Club-INTech/TechTheLunatic-LowLevel/datasheet/STM32F4/Pinout_STM32_F4DISCOVERY.xls

Sheet: Module Pins
STM32F4-Discovery Module - Pinouts & Alternate Functions (Sorted by Module Pin Order)
Kornak-(STM32-Discovery-F4)-0001 Rev n.nn Module Pinouts & Functions.xls
 |  |  |  |  |  |  | GND | P1.1 | P1.2 | GND | GND | P2.1 | P2.2 | GND
Version | Date | Who | Description |  |  |  | VDD | P1.3 | P1.4 | VDD | 5V | P2.3 | P2.4 | 5V
1.00 | 2011-12-19 | SK | Original Release. |  |  |  | GND | P1.5 | P1.6 | NRST | 3V | P2.5 | P2.6 | 3V
1.01 | 2014-09-17 | SK | Web page links updated for BusBoard.com |  |  |  | PC1 | P1.7 | P1.8 | PC0 | PH0 | P2.7 | P2.8 | PH1
 |  |  |  |  |  |  | PC3 | P1.9 | P1.10 | PC2 | PC14 | P2.9 | P2.10 | PC15
 |  |  |  |  |  |  | PA1 | P1.11 | P1.12 | PA0 | PE6 | P2.11 | P2.12 | PC13
 |  |  |  |  |  |  | PA3 | P1.13 | P1.14 | PA2 | PE4 | P2.13 | P2.14 | PE5
 |  |  |  |  |  |  | PA5 | P1.15 | P1.16 | PA4 | PE2 | P2.15 | P2.16 | PE3
 |  |  |  |  |  |  | PA7 | P1.17 | P1.18 | PA6 | PE0 | P2.17 | P2.18 | PE1
 |  |  |  |  |  |  | PC5 | P1.19 | P1.20 | PC4 | PB8 | P2.19 | P2.20 | PB9
 |  |  |  |  |  |  | PB1 | P1.21 | P1.22 | PB0 | BOOT0 | P2.21 | P2.22 | VDD | VDD connected to 3V on module.
 |  |  |  |  |  |  | GND | P1.23 | P1.24 | PB2 | PB6 | P2.23 | P2.24 | PB7
Update the version history above when making changes. |  |  |  |  |  |  | PE7 | P1.25 | P1.26 | PE8 | PB4 | P2.25 | P2.26 | PB5
 |  |  |  |  |  |  | PE9 | P1.27 | P1.28 | PE10 | PD7 | P2.27 | P2.28 | PB3
 |  |  |  |  |  |  | PE11 | P1.29 | P1.30 | PE12 | PD5 | P2.29 | P2.30 | PD6
Pins are sorted in Discovery board pin order on this page. |  |  |  |  |  |  | PE13 | P1.31 | P1.32 | PE14 | PD3 | P2.31 | P2.32 | PD4
Pins are sorted by function and MCU pin order |  |  |  |  |  |  | PE15 | P1.33 | P1.34 | PB10 | PD1 | P2.33 | P2.34 | PD2
on the other spreadsheet tabs. |  |  |  |  |  |  | PB11 | P1.35 | P1.36 | PB12 | PC12 | P2.35 | P2.36 | PD0
 |  |  |  |  |  |  | PB13 | P1.37 | P1.38 | PB14 | PC10 | P2.37 | P2.38 | PC11
 |  |  |  |  |  |  | PB15 | P1.39 | P1.40 | PD8 | PA14 | P2.39 | P2.40 | PA15
 |  |  |  |  |  |  | PD9 | P1.41 | P1.42 | PD10 | PA10 | P2.41 | P2.42 | PA13
 |  |  | Place the pin function |  |  |  | PD11 | P1.43 | P1.44 | PD12 | PA8 | P2.43 | P2.44 | PA9
 |  |  | and name for your |  |  |  | PD13 | P1.45 | P1.46 | PD14 | PC8 | P2.45 | P2.46 | PC9
 |  |  | project here. |  |  |  | PD15 | P1.47 | P1.48 | NC | PC6 | P2.47 | P2.48 | PC7
 |  |  | V V V V V V V V |  |  |  | GND | P1.49 | P1.50 | GND | GND | P2.49 | P2.50 | GND
 |  |  |  |  |  |  |  | Note: Color codes are different below
STM32F4 Pin | Discovery F4 Pin | LQFP100 | Project Pin Name and Function | Notes | Discovery F4 Usage | I/O Level | Function (1) after reset | Alternate functions (2)
PA11 | CN5 (USB) | 70 | PA11-OTG_FS_DM |  | USB-FS | FT | PA11 | USART1_CTS | CAN1_RX | TIM1_CH4 | OTG_FS_DM
PA12 | CN5 (USB) | 71 | PA12-OTG_FS_DP |  | USB-FS | FT | PA12 | USART1_RTS | CAN1_TX | TIM1_ETR | OTG_FS_DP
GND | P1.1 |  | GND1
GND | P1.2 |  | GND2
VDD | P1.3 |  | VDD1
VDD | P1.4 |  | VDD2
GND | P1.5 |  | GND3
NRST | P1.6 | 14 | NRST |  | Reset Button |  | NRST
PC1 | P1.7 | 16 | PC1-ADC123_IN11 | 5 |  | FT | PC1 | ETH_MDC | ADC123_IN11
PC0 | P1.8 | 15 | PC0-OTG_ FS_ Power | 5 | USB-FS | FT | PC0 | OTG_HS_ULPI_STP | ADC123_IN10
PC3 | P1.9 | 18 | PC3-MIC_PDM | 5 | MIC PDM | FT | PC3 | SPI2_MOSI | I2S2_SD | OTG_HS_ULPI_NXT | ETH_MII_TX_CLK | ADC123_IN13
PC2 | P1.10 | 17 | PC2-ADC123_IN12 | 5 |  | FT | PC2 | SPI2_MISO | OTG_HS_ULPI_DIR | TH_MII_TXD2 | I2S2ext_SD | ADC123_IN12
PA1 | P1.11 | 24 | PA1-USART4_RX | 5 |  | FT | PA1 | USART2_RTS | USART4_RX | ETH_RMII_REF_CLK | ETH_MII_RX_CLK | TIM5_CH2 | TIMM2_CH2 | ADC123_IN1
PA0-WKUP | P1.12 | 23 | PA0-WKUP-USART4_TX | 6,5 | User Button | FT | PA0-WKUP | USART2_CTS | USART4_TX | ETH_MII_CRS | TIM2_CH1_ETR | TIM5_CH1 | TIM8_ETR | ADC123_IN0 | WKUP
PA3 | P1.13 | 26 | PA3-USART2_RX | 5 |  | FT | PA3 | USART2_RX | TIM5_CH4 | TIM9_CH2 | TIM2_CH4 | OTG_HS_ULPI_D0 | ETH_MII_COL | ADC123_IN3
PA2 | P1.14 | 25 | PA2-USART2_TX | 5 |  | FT | PA2 | USART2_TX | TIM5_CH3 | TIM9_CH1 | TIM2_CH3 | ETH_MDIO | ADC123_IN2
PA5 | P1.15 | 30 | PA5-SPI1_SCK | 5 | MEMS SCLK | FT | PA5 | SPI1_SCK | OTG_HS_ULPI_CK | TIM2_CH1_ETR | TIM8_CHIN | ADC12_IN5 | DAC2_OUT
PA4 | P1.16 | 29 | PA4-I2S3_WS | 5 | DAC | FT | PA4 | SPI1_NSS | SPI3_NSS | USART2_CK | DCMI_HSYNC | OTG_HS_SOF | I2S3_WS | ADC12_IN4 | DAC1_OUT
PA7 | P1.17 | 32 | PA7-SPI1_MOSI | 5 | MEMS MOSI | FT | PA7 | SPI1_MOSI | TIM8_CH1N | TIM14_CH1 | TIM3_CH2 | ETH_MII_RX_DV | TIM1_CH1 | NRMII_CRS_DV | ADC12_IN7
PA6 | P1.18 | 31 | PA6-SPI1_MISO | 5 | MEMS MISO | FT | PA6 | SPI1_MISO | TIM8_BKIN | TIM13_CH1 | DCMI_PIXCLK | TIM3_CH1 | TIM1_BKIN | ADC12_IN6
PC5 | P1.19 | 34 | PC5-ADC12_IN15 | 5 |  | FT | PC5 | ETH_RMII_RX_D1 | ETH_MII_RX_D1 | ADC12_IN15
PC4 | P1.20 | 33 | PC4-ADC12_IN14 | 5 |  | FT | PC4 | ETH_RMII_RX_D0 | ETH_MII_RX_D0 | ADC12_IN14
PB1 | P1.21 | 36 | PB1-ADC12_IN9 | 5 |  | FT | PB1 | TIM3_CH4 | TIM8_CH3N | OTG_HS_ULPI_D2 | ETH_MII_RXD3 | OTG_HS_INTN | TIM1_CH3N | ADC12_IN9
PB0 | P1.22 | 35 | PB0-ADC12_IN8 | 5 |  | FT | PB0 | TIM3_CH3 | TIM8_CH2N | OTG_HS_ULPI_D1 | ETH_MII_RXD2 | TIM1_CH2N | ADC12_IN8
GND | P1.23 |  | GND4
PB2 | P1.24 | 37 | PB2-BOOT1 |  |  | FT | PB2-BOOT1
PE7 | P1.25 | 38 | PE7 |  |  | FT | PE7 | FSMC_D4 | TIM1_ETR
PE8 | P1.26 | 39 | PE8 |  |  | FT | PE8 | FSMC_D5 | TIM1_CH1N
PE9 | P1.27 | 40 | PE9 |  |  | FT | PE9 | FSMC_D6 | TIM1_CH1
PE10 | P1.28 | 41 | PE10 |  |  | FT | PE10 | FSMC_D7 | TIM1_CH2N
PE11 | P1.29 | 42 | PE11 |  |  | FT | PE11 | FSMC_D8 | TIM1_CH2
PE12 | P1.30 | 43 | PE12 |  |  | FT | PE12 | FSMC_D9 | TIM1_CH3N
PE13 | P1.31 | 44 | PE13 |  |  | FT | PE13 | FSMC_D10 | TIM1_CH3
PE14 | P1.32 | 45 | PE14 |  |  | FT | PE14 | FSMC_D11 | TIM1_CH4
PE15 | P1.33 | 46 | PE15 |  |  | FT | PE15 | FSMC_D12 | TIM1_BKIN
PB10 | P1.34 | 47 | PB10-I2C2_SCL |  | Also MIC CLK | FT | PB10 | SPI2_SCK | I2S2_CK | I2C2_SCL | USART3_TX | OTG_HS_ULPI_D3 | ETH_MII_RX_ER | OTG_HS_SCL | TIM2_CH3
PB11 | P1.35 | 48 | PB11-I2C2_SDA |  |  | FT | PB11 | I2C2_SDA | USART3_RX | OTG_HS_ULPI_D4 | ETH_RMII_TX_EN | ETH_MII_TX_EN | OTG_HS_SDA | TIM2_CH4
PB12 | P1.36 | 51 | PB12-SPI2_NSS |  |  | FT | PB12 | SPI2_NSS | I2S2_WS | I2C2_SMBA | USART3_CK | TIM1_BKIN | CAN2_RX | OTG_HS_ULPI_D5 | ETH_RMII_TXD0 | ETH_MII_TXD0 | OTG_HS_ID
PB13 | P1.37 | 52 | PB13-SPI2_SCK |  |  | FT | PB13 | SPI2_SCK | I2S2_CK | USART3_CTS | TIM1_CH1N | CAN2_TX | OTG_HS_ULPI_D6 | ETH_RMII_TXD1 | ETH_MII_TXD1 | OTG_HS_VBUS
PB14 | P1.38 | 53 | PB14-SPI2_MISO |  |  | FT | PB14 | SPI2_MISO | TIM1_CH2N | TIM12_CH1 | OTG_HS_DM | USART3_RTS | TIM8_CH2N | I2S2ext_SD
PB15 | P1.39 | 54 | PB15-SPI2_MOSI |  |  | FT | PB15 | SPI2_MOSI | I2S2_SD | TIM1_CH3N | TIM8_CH3N | TIM12_CH2 | OTG_HS_DP
PD8 | P1.40 | 55 | PD8-USART3_TX |  |  | FT | PD8 | FSMC_D13 | USART3_TX
PD9 | P1.41 | 56 | PD9-USART3_RX |  |  | FT | PD9 | FSMC_D14 | USART3_RX
PD10 | P1.42 | 57 | PD10 |  |  | FT | PD10 | FSMC_D15 | USART3_CK
PD11 | P1.43 | 58 | PD11-USART3_CTS |  |  | FT | PD11 | FSMC_A16 | USART3_CTS
PD12 | P1.44 | 59 | PD12-USART3_RTS |  | LED Green | FT | PD12 | FSMC_A17 | TIM4_CH1 | USART3_RTS
PD13 | P1.45 | 60 | PD13 |  | LED Orange | FT | PD13 | FSMC_A18 | TIM4_CH2
PD14 | P1.46 | 61 | PD14 |  | LED Red | FT | PD14 | FSMC_D0 | TIM4_CH3
PD15 | P1.47 | 62 | PD15 |  | LED Blue | FT | PD15 | FSMC_D1 | TIM4_CH4
NC | P1.48 |  | NC
GND | P1.49 |  | GND5
GND | P1.50 |  | GND6
GND | P2.1 (51) |  | GND7
GND | P2.2 (52) |  | GND8
5V | P2.3 (53) |  | 5V-1
5V | P2.4 (54) |  | 5V-2
3V | P2.5 (55) |  | 3V-1
3V | P2.6 (56) |  | 3V-2
PH0 | P2.7 (57) | 12 | PH0-OSC_IN | 5 |  | FT | PH0 | OSC_IN
PH1 | P2.8 (58) | 13 | PH1-OSC_OUT | 5 |  | FT | PH1 | OSC_OUT
PC14 | P2.9 (59) | 8 | PC14-OSC32_IN | 3,5 |  | FT | PC14(4) | OSC32_IN
PC15 | P2.10 (60) | 9 | PC15-OSC32_OUT | 3,5 |  | FT | PC15(4) | OSC32_OUT
PE6 | P2.11 (61) | 5 | PE6 |  |  | FT | PE6 | TRACED3 | FSMC_A22 | TIM9_CH2 | DCMI_D7
PC13 | P2.12 (62) | 7 | PC13 | 3,4 |  | FT | PC13(4) | RTC_AF1
PE4 | P2.13 (63) | 3 | PE4 |  |  | FT | PE4 | TRACED1 | FSMC_A20 | DCMI_D4
PE5 | P2.14 (64) | 4 | PE5 |  |  | FT | PE5 | TRACED2 | FSMC_A21 | TIM9_CH1 | DCMI_D6
PE2 | P2.15 (65) | 1 | PE2 |  |  | FT | PE2 | TRACECLK | FSMC_A23 | ETH_MII_TXD3
PE3 | P2.16 (66) | 2 | PE3 |  | MEMS CS_I2C_SPI | FT | PE3 | TRACED0 | FSMC_A19
PE0 | P2.17 (67) | 97 | PE0 |  | MEMS INT1 | FT | PE0 | TIM4_ETR | FSMC_NBL0 | DCMI_D2
PE1 | P2.18 (68) | 98 | PE1 |  | MEMS INT2 | FT | PE1 | FSMC_NBL1 | DCMI_D3
PB8 | P2.19 (69) | 95 | PB8 |  |  | FT | PB8 | TIM4_CH3 | SDIO_D4 | TIM10_CH1 | DCMI_D6 | OTG_FS_SCL | ETH_MII_TXD3 | I2C1_SCL | CAN1_RX
PB9 | P2.20 (70) | 96 | PB9-I2C1_SDA |  | DAC I2C | FT | PB9 | SPI2_NSS | I2S2_WS | TIM4_CH4 | TIM11_CH1 | OTG_FS_SDA | SDIO_D5 | DCMI_D7 | I2C1_SDA | CAN1_TX
BOOT0 | P2.21 (71) | 94 | BOOT0 |  |  |  | BOOT0 | VPP
VDD | P2.22 (72) |  | VDD3
PB6 | P2.23 (73) | 92 | PB6-I2C1_SCL |  | DAC I2C | FT | PB6 | I2C1_SCL | TIM4_CH1 | CAN2_TX | OTG_FS_INTN | DCMI_D5 | USART1_TX
PB7 | P2.24 (74) | 93 | PB7 |  |  | FT | PB7 | I2C1_SDA | FSMC_NL | DCMI_VSYNC | USART1_RX | TIM4_CH2
PB4 | P2.25 (75) | 90 | PB4-NJTRST |  |  | FT | NJTRST | NJTRST | SPI3_MISO | TIM3_CH1 | SPI1_MISO | I2S3ext_SD
PB5 | P2.26 (76) | 91 | PB5-I2C1_SMBA |  |  | FT | PB5 | I2C1_SMBA | CAN2_RX | OTG_HS_ULPI_D7 | ETH_PPS_OUT | TIM3_CH2 | SPI1_MOSI | SPI3_MOSI | DCMI_D10 | I2S3_SD
PD7 | P2.27 (77) | 88 | PD7 |  |  | FT | PD7 | USART2_CK | FSMC_NE1 | FSMC_NCE2
PB3 | P2.28 (78) | 89 | PB3-JTDO |  |  | FT | JTDO | TRACESWO | JTDO | SPI3_SCK | I2S3_CK | SPI1_SCK | TIM2_CH2
PD5 | P2.29 (79) | 86 | PD5-OTG_ FS_ OverCurrent |  | USB-FS | FT | PD5 | FSMC_NWE | USART2_TX
PD6 | P2.30 (80) | 87 | PD6 |  |  | FT | PD6 | FSMC_NWAIT | USART2_RX
PD3 | P2.31 (81) | 84 | PD3 |  |  | FT | PD3 | FSMC_CLK | USART2_CTS
PD4 | P2.32 (82) | 85 | PD4-AUDIO_RESET_N |  | DAC-Reset-N | FT | PD4 | FSMC_NOE | USART2_RTS
PD1 | P2.33 (83) | 82 | PD1-CAN1_TX |  |  | FT | PD1 | FSMC_D3 | CAN1_TX
PD2 | P2.34 (84) | 83 | PD2 |  |  | FT | PD2 | TIM3_ETR | UART5_RX | SDIO_CMD | DCMI_D11
PC12 | P2.35 (85) | 80 | PC12-I2S3_SD |  | DAC | FT | PC12 | UART5_TX | SDIO_CK | DCMI_D9 | SPI3_MOSI | I2S3_SD | USART3_CK
PD0 | P2.36 (86) | 81 | PD0-CAN1_RX |  |  | FT | PD0 | FSMC_D2 | CAN1_RX
PC10 | P2.37 (87) | 78 | PC10-I2S3_CK |  | DAC | FT | PC10 | SPI3_SCK | I2S3_CK | UART4_TX | SDIO_D2 | USART3_TX | DCMI_D8
PC11 | P2.38 (88) | 79 | PC11 |  |  | FT | PC11 | UART4_RX | SPI3_MISO | SDIO_D3 | DCMI_D4 | USART3_RX | I2S3ext_SD
PA14 | P2.39 (89) | 76 | PA14-JTCK-SWCLK |  |  | FT | JTCK-SWCLK | JTCK-SWCLK
PA15 | P2.40 (90) | 77 | PA15-JTDI |  |  | FT | JTDI | JTDI | SPI3_NSS | I2S3_WS | TIM2_CH1_ETR | SPI1_NSS
PA10 | P2.41 (91) | 69 | PA10-OTG_FS_ID |  | USB-FS | FT | PA10 | USART1_RX | TIM1_CH3 | OTG_FS_ID | DCMI_D1
PA13 | P2.42 (92) | 72 | PA13-JTMS-SWDIO |  |  | FT | JTMS-SWDIO | JTMS-SWDIO
PA8 | P2.43 (93) | 67 | PA8-I2C3_SCL |  |  | FT | PA8 | MCO1 | USART1_CK | TIM1_CH1 | I2C3_SCL | OTG_FS_SOF
PA9 | P2.44 (94) | 68 | PA9-OTG_FS_VBUS |  | USB-FS | FT | PA9 | USART1_TX | TIM1_CH2 | I2C3_SMBA | DCMI_D0 | OTG_FS_VBUS
PC8 | P2.45 (95) | 65 | PC8 |  |  | FT | PC8 | TIM8_CH3 | SDIO_D0 | TIM3_CH3 | USART6_CK | DCMI_D2
PC9 | P2.46 (96) | 66 | PC9-I2C3_SDA |  |  | FT | PC9 | I2S_CKIN | MCO2 | TIM8_CH4 | SDIO_D1 | DCMI_D3 | TIM3_CH4 | I2C3_SDA
PC6 | P2.47 (97) | 63 | PC6 |  |  | FT | PC6 | I2S2_MCK | TIM8_CH1 | SDIO_D6 | USART6_TX | DCMI_D0 | TIM3_CH1
PC7 | P2.48 (98) | 64 | PC7-I2S3_MCK |  | DAC | FT | PC7 | I2S3_MCK | TIM8_CH2 | SDIO_D7 | USART6_RX | DCMI_D1 | TIM3_CH2
GND | P2.49 (99) |  | GND9
GND | P2.50 (100) |  | GND10
 |  |  |  | See pin notes on the "MCU pins" tab/sheet.
The pin information is Copyright 2011 ST Microelectronics.
This spreadsheet, additional information, and the table organization is Copyright 2011 by Kornak Technologies Inc.
This spreadsheet may be freely distributed and modified for personal or commercial use with the Copyright attributions intact.
Kornak Technologies provides embedded product development and manufacturing services
including STM32 hardware and firmware development. |  |  |  |  |  |  |  |  |  |  | www.Kornak.ca
This spreadsheet and updated versions can be downloaded from: |  |  |  |  |  | http://busboard.us/products/PCB-STM32-F4B1/ (http://www.kornak.ca/parts/stm32-discovery-f4/)
The BusBoard STM32-F4B1 breakout board is available for the STMicro Discovery-F4 module.
Datasheets, photos, BOMs, and schematics are available at: |  |  |  |  |  | http://busboard.com/PCB-STM32-F4B1/
The BusBoard-3U (BB3U) prototyping board can be used to create a baseboard for the STM32F4 Discovery module.
The zig-zag pattern is helpful for the STM32F4-Discovery module because it keeps both sides of the DIL header on separate tracks. |  |  |  |  |  |  |  |  |  |  | www.BusBoard.com
It can be used to connect two DIL headers pin-to-pin without cutting any tracks. |  |  |  |  |  |  | http://busboard.com/KIT-BB2-F3-F4
 |  |  |  |  |  |  | http://busboard.com/KIT-BB3-F3-F4
BPS also sells high-quality solderless breadboards and solderable PC prototyping boards
which can help with Discovery-F4 interfacing.
BB400 breadboards make great bases for STM32 Discovery-L and Discovery-VL modules with SIL headers.
BPS products are available at:
www.Mouser.com |  |  | BPS Products at Mouser (http://www.mouser.com/bps)
www.Amazon.com |  |  | BPS Products at Amazon.com (http://www.amazon.com/shops/A2RKGEIGG4B1JT/ref=olp_merch_name_1)
www.Amazon.co.uk |  |  | BPS Products at Amazon.co.uk (http://www.amazon.co.uk/s?search-type=ss&index=electronics-uk&field-keywords=BusBoard%20Prototype%20Systems)

Sheet: By Function
STM32F4-Discovery Module - Pinouts & Alternate Functions (Sorted by typical Pin Function)
Kornak-(STM32-Discovery-F4)-0001 Rev n.nn Module Pinouts & Functions.xls
 |  |  | The formulas |  | This spreadsheet is intended to help you plan you project pinout assignments.
 |  |  | combine the pin name
 |  |  | with the function. |  | Rearrange the rows according to the pin functions you choose to group pins with common functions.
 |  |  | V V V V V V V V
STM32F4 Pin | Discovery F4 Pin | LQFP100 | Project Pin Name and Function | Notes | Discovery F4 Usage | I/O Level | Function (1) after reset | Alternate functions (2)
PA11 | CN5 (USB) | 70 | PA11-OTG_FS_DM |  | USB-FS | FT | PA11 | USART1_CTS | CAN1_RX | TIM1_CH4 | OTG_FS_DM
PA12 | CN5 (USB) | 71 | PA12-OTG_FS_DP |  | USB-FS | FT | PA12 | USART1_RTS | CAN1_TX | TIM1_ETR | OTG_FS_DP
PA9 | P2.44 | 68 | PA9-OTG_FS_VBUS |  | USB-FS | FT | PA9 | USART1_TX | TIM1_CH2 | I2C3_SMBA | DCMI_D0 | OTG_FS_VBUS
PA10 | P2.41 | 69 | PA10-OTG_FS_ID |  | USB-FS | FT | PA10 | USART1_RX | TIM1_CH3 | OTG_FS_ID | DCMI_D1
PC0 | P1.8 | 15 | PC0-OTG_ FS_ Power | 5 | USB-FS | FT | PC0 | OTG_HS_ULPI_STP | ADC123_IN10
PD5 | P2.29 | 86 | PD5-OTG_ FS_ OverCurrent |  | USB-FS | FT | PD5 | FSMC_NWE | USART2_TX
PA2 | P1.14 | 25 | PA2-USART2_TX | 5 |  | FT | PA2 | USART2_TX | TIM5_CH3 | TIM9_CH1 | TIM2_CH3 | ETH_MDIO | ADC123_IN2
PA3 | P1.13 | 26 | PA3-USART2_RX | 5 |  | FT | PA3 | USART2_RX | TIM5_CH4 | TIM9_CH2 | TIM2_CH4 | OTG_HS_ULPI_D0 | ETH_MII_COL | ADC123_IN3
PD8 | P1.40 | 55 | PD8-USART3_TX |  |  | FT | PD8 | FSMC_D13 | USART3_TX
PD9 | P1.41 | 56 | PD9-USART3_RX |  |  | FT | PD9 | FSMC_D14 | USART3_RX
PD11 | P1.43 | 58 | PD11-USART3_CTS |  |  | FT | PD11 | FSMC_A16 | USART3_CTS
PD12 | P1.44 | 59 | PD12-USART3_RTS |  | LED Green | FT | PD12 | FSMC_A17 | TIM4_CH1 | USART3_RTS
PA0-WKUP | P1.12 | 23 | PA0-WKUP-USART4_TX | 6,5 | User Button | FT | PA0-WKUP | USART2_CTS | USART4_TX | ETH_MII_CRS | TIM2_CH1_ETR | TIM5_CH1 | TIM8_ETR | ADC123_IN0 | WKUP
PA1 | P1.11 | 24 | PA1-USART4_RX | 5 |  | FT | PA1 | USART2_RTS | USART4_RX | ETH_RMII_REF_CLK | ETH_MII_RX_CLK | TIM5_CH2 | TIMM2_CH2 | ADC123_IN1
PC7 | P2.48 | 64 | PC7-I2S3_MCK |  | DAC | FT | PC7 | I2S3_MCK | TIM8_CH2 | SDIO_D7 | USART6_RX | DCMI_D1 | TIM3_CH2
PC10 | P2.37 | 78 | PC10-I2S3_CK |  | DAC | FT | PC10 | SPI3_SCK | I2S3_CK | UART4_TX | SDIO_D2 | USART3_TX | DCMI_D8
PC12 | P2.35 | 80 | PC12-I2S3_SD |  | DAC | FT | PC12 | UART5_TX | SDIO_CK | DCMI_D9 | SPI3_MOSI | I2S3_SD | USART3_CK
PA4 | P1.16 | 29 | PA4-I2S3_WS | 5 | DAC | FT | PA4 | SPI1_NSS | SPI3_NSS | USART2_CK | DCMI_HSYNC | OTG_HS_SOF | I2S3_WS | ADC12_IN4 | DAC1_OUT
PD4 | P2.32 | 85 | PD4-AUDIO_RESET_N |  | DAC-Reset-N | FT | PD4 | FSMC_NOE | USART2_RTS
PD0 | P2.36 | 81 | PD0-CAN1_RX |  |  | FT | PD0 | FSMC_D2 | CAN1_RX
PD1 | P2.33 | 82 | PD1-CAN1_TX |  |  | FT | PD1 | FSMC_D3 | CAN1_TX
PB0 | P1.22 | 35 | PB0-ADC12_IN8 | 5 |  | FT | PB0 | TIM3_CH3 | TIM8_CH2N | OTG_HS_ULPI_D1 | ETH_MII_RXD2 | TIM1_CH2N | ADC12_IN8
PB1 | P1.21 | 36 | PB1-ADC12_IN9 | 5 |  | FT | PB1 | TIM3_CH4 | TIM8_CH3N | OTG_HS_ULPI_D2 | ETH_MII_RXD3 | OTG_HS_INTN | TIM1_CH3N | ADC12_IN9
PC1 | P1.7 | 16 | PC1-ADC123_IN11 | 5 |  | FT | PC1 | ETH_MDC | ADC123_IN11
PC2 | P1.10 | 17 | PC2-ADC123_IN12 | 5 |  | FT | PC2 | SPI2_MISO | OTG_HS_ULPI_DIR | TH_MII_TXD2 | I2S2ext_SD | ADC123_IN12
PC4 | P1.20 | 33 | PC4-ADC12_IN14 | 5 |  | FT | PC4 | ETH_RMII_RX_D0 | ETH_MII_RX_D0 | ADC12_IN14
PC5 | P1.19 | 34 | PC5-ADC12_IN15 | 5 |  | FT | PC5 | ETH_RMII_RX_D1 | ETH_MII_RX_D1 | ADC12_IN15
PA5 | P1.15 | 30 | PA5-SPI1_SCK | 5 | MEMS SCLK | FT | PA5 | SPI1_SCK | OTG_HS_ULPI_CK | TIM2_CH1_ETR | TIM8_CHIN | ADC12_IN5 | DAC2_OUT
PA6 | P1.18 | 31 | PA6-SPI1_MISO | 5 | MEMS MISO | FT | PA6 | SPI1_MISO | TIM8_BKIN | TIM13_CH1 | DCMI_PIXCLK | TIM3_CH1 | TIM1_BKIN | ADC12_IN6
PA7 | P1.17 | 32 | PA7-SPI1_MOSI | 5 | MEMS MOSI | FT | PA7 | SPI1_MOSI | TIM8_CH1N | TIM14_CH1 | TIM3_CH2 | ETH_MII_RX_DV | TIM1_CH1 | NRMII_CRS_DV | ADC12_IN7
PB13 | P1.37 | 52 | PB13-SPI2_SCK |  |  | FT | PB13 | SPI2_SCK | I2S2_CK | USART3_CTS | TIM1_CH1N | CAN2_TX | OTG_HS_ULPI_D6 | ETH_RMII_TXD1 | ETH_MII_TXD1 | OTG_HS_VBUS
PB14 | P1.38 | 53 | PB14-SPI2_MISO |  |  | FT | PB14 | SPI2_MISO | TIM1_CH2N | TIM12_CH1 | OTG_HS_DM | USART3_RTS | TIM8_CH2N | I2S2ext_SD
PB15 | P1.39 | 54 | PB15-SPI2_MOSI |  |  | FT | PB15 | SPI2_MOSI | I2S2_SD | TIM1_CH3N | TIM8_CH3N | TIM12_CH2 | OTG_HS_DP
PB12 | P1.36 | 51 | PB12-SPI2_NSS |  |  | FT | PB12 | SPI2_NSS | I2S2_WS | I2C2_SMBA | USART3_CK | TIM1_BKIN | CAN2_RX | OTG_HS_ULPI_D5 | ETH_RMII_TXD0 | ETH_MII_TXD0 | OTG_HS_ID
PA13 | P2.42 | 72 | PA13-JTMS-SWDIO |  |  | FT | JTMS-SWDIO | JTMS-SWDIO
PA14 | P2.39 | 76 | PA14-JTCK-SWCLK |  |  | FT | JTCK-SWCLK | JTCK-SWCLK
PA15 | P2.40 | 77 | PA15-JTDI |  |  | FT | JTDI | JTDI | SPI3_NSS | I2S3_WS | TIM2_CH1_ETR | SPI1_NSS
PB3 | P2.28 | 89 | PB3-JTDO |  |  | FT | JTDO | TRACESWO | JTDO | SPI3_SCK | I2S3_CK | SPI1_SCK | TIM2_CH2
PB4 | P2.25 | 90 | PB4-NJTRST |  |  | FT | NJTRST | NJTRST | SPI3_MISO | TIM3_CH1 | SPI1_MISO | I2S3ext_SD
PB6 | P2.23 | 92 | PB6-I2C1_SCL |  | DAC I2C | FT | PB6 | I2C1_SCL | TIM4_CH1 | CAN2_TX | OTG_FS_INTN | DCMI_D5 | USART1_TX
PB9 | P2.20 | 96 | PB9-I2C1_SDA |  | DAC I2C | FT | PB9 | SPI2_NSS | I2S2_WS | TIM4_CH4 | TIM11_CH1 | OTG_FS_SDA | SDIO_D5 | DCMI_D7 | I2C1_SDA | CAN1_TX
PB10 | P1.34 | 47 | PB10-I2C2_SCL |  | Also MIC CLK | FT | PB10 | SPI2_SCK | I2S2_CK | I2C2_SCL | USART3_TX | OTG_HS_ULPI_D3 | ETH_MII_RX_ER | OTG_HS_SCL | TIM2_CH3
PB11 | P1.35 | 48 | PB11-I2C2_SDA |  |  | FT | PB11 | I2C2_SDA | USART3_RX | OTG_HS_ULPI_D4 | ETH_RMII_TX_EN | ETH_MII_TX_EN | OTG_HS_SDA | TIM2_CH4
PB5 | P2.26 | 91 | PB5-I2C1_SMBA |  |  | FT | PB5 | I2C1_SMBA | CAN2_RX | OTG_HS_ULPI_D7 | ETH_PPS_OUT | TIM3_CH2 | SPI1_MOSI | SPI3_MOSI | DCMI_D10 | I2S3_SD
PA8 | P2.43 | 67 | PA8-I2C3_SCL |  |  | FT | PA8 | MCO1 | USART1_CK | TIM1_CH1 | I2C3_SCL | OTG_FS_SOF
PC9 | P2.46 | 66 | PC9-I2C3_SDA |  |  | FT | PC9 | I2S_CKIN | MCO2 | TIM8_CH4 | SDIO_D1 | DCMI_D3 | TIM3_CH4 | I2C3_SDA
PD13 | P1.45 | 60 | PD13 |  | LED Orange | FT | PD13 | FSMC_A18 | TIM4_CH2
PD14 | P1.46 | 61 | PD14 |  | LED Red | FT | PD14 | FSMC_D0 | TIM4_CH3
PD15 | P1.47 | 62 | PD15 |  | LED Blue | FT | PD15 | FSMC_D1 | TIM4_CH4
PC3 | P1.9 | 18 | PC3-MIC_PDM | 5 | MIC PDM | FT | PC3 | SPI2_MOSI | I2S2_SD | OTG_HS_ULPI_NXT | ETH_MII_TX_CLK | ADC123_IN13
PB7 | P2.24 | 93 | PB7 |  |  | FT | PB7 | I2C1_SDA | FSMC_NL | DCMI_VSYNC | USART1_RX | TIM4_CH2
PB8 | P2.19 | 95 | PB8 |  |  | FT | PB8 | TIM4_CH3 | SDIO_D4 | TIM10_CH1 | DCMI_D6 | OTG_FS_SCL | ETH_MII_TXD3 | I2C1_SCL | CAN1_RX
PC11 | P2.38 | 79 | PC11 |  |  | FT | PC11 | UART4_RX | SPI3_MISO | SDIO_D3 | DCMI_D4 | USART3_RX | I2S3ext_SD
PC13 | P2.12 | 7 | PC13 | 3,4 |  | FT | PC13(4) | RTC_AF1
PC6 | P2.47 | 63 | PC6 |  |  | FT | PC6 | I2S2_MCK | TIM8_CH1 | SDIO_D6 | USART6_TX | DCMI_D0 | TIM3_CH1
PC8 | P2.45 | 65 | PC8 |  |  | FT | PC8 | TIM8_CH3 | SDIO_D0 | TIM3_CH3 | USART6_CK | DCMI_D2
PD2 | P2.34 | 83 | PD2 |  |  | FT | PD2 | TIM3_ETR | UART5_RX | SDIO_CMD | DCMI_D11
PD3 | P2.31 | 84 | PD3 |  |  | FT | PD3 | FSMC_CLK | USART2_CTS
PD6 | P2.30 | 87 | PD6 |  |  | FT | PD6 | FSMC_NWAIT | USART2_RX
PD7 | P2.27 | 88 | PD7 |  |  | FT | PD7 | USART2_CK | FSMC_NE1 | FSMC_NCE2
PD10 | P1.42 | 57 | PD10 |  |  | FT | PD10 | FSMC_D15 | USART3_CK
PE0 | P2.17 | 97 | PE0 |  | MEMS INT1 | FT | PE0 | TIM4_ETR | FSMC_NBL0 | DCMI_D2
PE1 | P2.18 | 98 | PE1 |  | MEMS INT2 | FT | PE1 | FSMC_NBL1 | DCMI_D3
PE2 | P2.15 | 1 | PE2 |  |  | FT | PE2 | TRACECLK | FSMC_A23 | ETH_MII_TXD3
PE3 | P2.16 | 2 | PE3 |  | MEMS CS_I2C_SPI | FT | PE3 | TRACED0 | FSMC_A19
PE4 | P2.13 | 3 | PE4 |  |  | FT | PE4 | TRACED1 | FSMC_A20 | DCMI_D4
PE5 | P2.14 | 4 | PE5 |  |  | FT | PE5 | TRACED2 | FSMC_A21 | TIM9_CH1 | DCMI_D6
PE6 | P2.11 | 5 | PE6 |  |  | FT | PE6 | TRACED3 | FSMC_A22 | TIM9_CH2 | DCMI_D7
PE7 | P1.25 | 38 | PE7 |  |  | FT | PE7 | FSMC_D4 | TIM1_ETR
PE8 | P1.26 | 39 | PE8 |  |  | FT | PE8 | FSMC_D5 | TIM1_CH1N
PE9 | P1.27 | 40 | PE9 |  |  | FT | PE9 | FSMC_D6 | TIM1_CH1
PE10 | P1.28 | 41 | PE10 |  |  | FT | PE10 | FSMC_D7 | TIM1_CH2N
PE11 | P1.29 | 42 | PE11 |  |  | FT | PE11 | FSMC_D8 | TIM1_CH2
PE12 | P1.30 | 43 | PE12 |  |  | FT | PE12 | FSMC_D9 | TIM1_CH3N
PE13 | P1.31 | 44 | PE13 |  |  | FT | PE13 | FSMC_D10 | TIM1_CH3
PE14 | P1.32 | 45 | PE14 |  |  | FT | PE14 | FSMC_D11 | TIM1_CH4
PE15 | P1.33 | 46 | PE15 |  |  | FT | PE15 | FSMC_D12 | TIM1_BKIN
PH0 | P2.7 | 12 | PH0-OSC_IN | 5 |  | FT | PH0 | OSC_IN
PH1 | P2.8 | 13 | PH1-OSC_OUT | 5 |  | FT | PH1 | OSC_OUT
PC14 | P2.9 | 8 | PC14-OSC32_IN | 3,5 |  | FT | PC14(4) | OSC32_IN
PC15 | P2.10 | 9 | PC15-OSC32_OUT | 3,5 |  | FT | PC15(4) | OSC32_OUT
BOOT0 | P2.21 | 94 | BOOT0 |  |  |  | BOOT0 | VPP
PB2 | P1.24 | 37 | PB2-BOOT1 |  |  | FT | PB2-BOOT1
NRST | P1.6 | 14 | NRST |  | Reset Button |  | NRST
GND | P1.49
GND | P1.2
GND | P1.50
GND | P2.1
GND | P2.49
GND | P2.2
GND | P2.50
GND | P1.1
GND | P1.5
GND | P1.23
NC | P1.48
3V | P2.5
3V | P2.6
5V | P2.3
5V | P2.4
VDD | P1.3
VDD | P1.4
VDD | P2.22

Sheet: MCU Pins
STM32F4-Discovery Module - Pinouts & Alternate Functions (Sorted by MCU Port Pin Name)
Kornak-(STM32-Discovery-F4)-0001 Rev n.nn Module Pinouts & Functions.xls
STM32F4 Pin | Discovery F4 Pin | LQFP100 | Pin name | I/O Level | Function (1) after reset | Alternate functions (2)
PA0 | P1.12 | 23 | PA0(6)-WKUP(5) | FT | PA0-WKUP | USART2_CTS | USART4_TX | ETH_MII_CRS | TIM2_CH1_ETR | TIM5_CH1 | TIM8_ETR | ADC123_IN0 | WKUP
PA1 | P1.11 | 24 | PA1(5) | FT | PA1 | USART2_RTS | USART4_RX | ETH_RMII_REF_CLK | ETH_MII_RX_CLK | TIM5_CH2 | TIMM2_CH2 | ADC123_IN1
PA2 | P1.14 | 25 | PA2(5) | FT | PA2 | USART2_TX | TIM5_CH3 | TIM9_CH1 | TIM2_CH3 | ETH_MDIO | ADC123_IN2
PA3 | P1.13 | 26 | PA3(5) | FT | PA3 | USART2_RX | TIM5_CH4 | TIM9_CH2 | TIM2_CH4 | OTG_HS_ULPI_D0 | ETH_MII_COL | ADC123_IN3
PA4 | P1.16 | 29 | PA4(5) | FT | PA4 | SPI1_NSS | SPI3_NSS | USART2_CK | DCMI_HSYNC | OTG_HS_SOF | I2S3_WS | ADC12_IN4 | DAC1_OUT
PA5 | P1.15 | 30 | PA5(5) | FT | PA5 | SPI1_SCK | OTG_HS_ULPI_CK | TIM2_CH1_ETR | TIM8_CHIN | ADC12_IN5 | DAC2_OUT
PA6 | P1.18 | 31 | PA6(5) | FT | PA6 | SPI1_MISO | TIM8_BKIN | TIM13_CH1 | DCMI_PIXCLK | TIM3_CH1 | TIM1_BKIN | ADC12_IN6
PA7 | P1.17 | 32 | PA7(5) | FT | PA7 | SPI1_MOSI | TIM8_CH1N | TIM14_CH1 | TIM3_CH2 | ETH_MII_RX_DV | TIM1_CH1 | NRMII_CRS_DV | ADC12_IN7
PA8 | P2.43 | 67 | PA8 | FT | PA8 | MCO1 | USART1_CK | TIM1_CH1 | I2C3_SCL | OTG_FS_SOF
PA9 | P2.44 | 68 | PA9 | FT | PA9 | USART1_TX | TIM1_CH2 | I2C3_SMBA | DCMI_D0 | OTG_FS_VBUS
PA10 | P2.41 | 69 | PA10 | FT | PA10 | USART1_RX | TIM1_CH3 | OTG_FS_ID | DCMI_D1
PA11 | CN5 (USB) | 70 | PA11 | FT | PA11 | USART1_CTS | CAN1_RX | TIM1_CH4 | OTG_FS_DM
PA12 | CN5 (USB) | 71 | PA12 | FT | PA12 | USART1_RTS | CAN1_TX | TIM1_ETR | OTG_FS_DP
PA13 | P2.42 | 72 | PA13 | FT | JTMS-SWDIO | JTMS-SWDIO
PA14 | P2.39 | 76 | PA14 | FT | JTCK-SWCLK | JTCK-SWCLK
PA15 | P2.40 | 77 | PA15 | FT | JTDI | JTDI | SPI3_NSS | I2S3_WS | TIM2_CH1_ETR | SPI1_NSS
PB0 | P1.22 | 35 | PB0(5) | FT | PB0 | TIM3_CH3 | TIM8_CH2N | OTG_HS_ULPI_D1 | ETH_MII_RXD2 | TIM1_CH2N | ADC12_IN8
PB1 | P1.21 | 36 | PB1(5) | FT | PB1 | TIM3_CH4 | TIM8_CH3N | OTG_HS_ULPI_D2 | ETH_MII_RXD3 | OTG_HS_INTN | TIM1_CH3N | ADC12_IN9
PB2 | P1.24 | 37 | PB2 | FT | PB2-BOOT1
PB3 | P2.28 | 89 | PB3 | FT | JTDO | TRACESWO | JTDO | TRACESWO | SPI3_SCK | I2S3_CK | SPI1_SCK | TIM2_CH2
PB4 | P2.25 | 90 | PB4 | FT | NJTRST | NJTRST | SPI3_MISO | TIM3_CH1 | SPI1_MISO | I2S3ext_SD
PB5 | P2.26 | 91 | PB5 | FT | PB5 | I2C1_SMBA | CAN2_RX | OTG_HS_ULPI_D7 | ETH_PPS_OUT | TIM3_CH2 | SPI1_MOSI | SPI3_MOSI | DCMI_D10 | I2S3_SD
PB6 | P2.23 | 92 | PB6 | FT | PB6 | I2C1_SCL | TIM4_CH1 | CAN2_TX | OTG_FS_INTN | DCMI_D5 | USART1_TX
PB7 | P2.24 | 93 | PB7 | FT | PB7 | I2C1_SDA | FSMC_NL | DCMI_VSYNC | USART1_RX | TIM4_CH2
PB8 | P2.19 | 95 | PB8 | FT | PB8 | TIM4_CH3 | SDIO_D4 | TIM10_CH1 | DCMI_D6 | OTG_FS_SCL | ETH_MII_TXD3 | I2C1_SCL | CAN1_RX
PB9 | P2.20 | 96 | PB9 | FT | PB9 | SPI2_NSS | I2S2_WS | TIM4_CH4 | TIM11_CH1 | OTG_FS_SDA | SDIO_D5 | DCMI_D7 | I2C1_SDA | CAN1_TX
PB10 | P1.34 | 47 | PB10 | FT | PB10 | SPI2_SCK | I2S2_CK | I2C2_SCL | USART3_TX | OTG_HS_ULPI_D3 | ETH_MII_RX_ER | OTG_HS_SCL | TIM2_CH3
PB11 | P1.35 | 48 | PB11 | FT | PB11 | I2C2_SDA | USART3_RX | OTG_HS_ULPI_D4 | ETH_RMII_TX_EN | ETH_MII_TX_EN | OTG_HS_SDA | TIM2_CH4
PB12 | P1.36 | 51 | PB12 | FT | PB12 | SPI2_NSS | I2S2_WS | I2C2_SMBA | USART3_CK | TIM1_BKIN | CAN2_RX | OTG_HS_ULPI_D5 | ETH_RMII_TXD0 | ETH_MII_TXD0 | OTG_HS_ID
PB13 | P1.37 | 52 | PB13 | FT | PB13 | SPI2_SCK | I2S2_CK | USART3_CTS | TIM1_CH1N | CAN2_TX | OTG_HS_ULPI_D6 | ETH_RMII_TXD1 | ETH_MII_TXD1 | OTG_HS_VBUS
PB14 | P1.38 | 53 | PB14 | FT | PB14 | SPI2_MISO | TIM1_CH2N | TIM12_CH1 | OTG_HS_DM | USART3_RTS | TIM8_CH2N | I2S2ext_SD
PB15 | P1.39 | 54 | PB15 | FT | PB15 | SPI2_MOSI | I2S2_SD | TIM1_CH3N | TIM8_CH3N | TIM12_CH2 | OTG_HS_DP
PC0 | P1.8 | 15 | PC0(5) | FT | PC0 | OTG_HS_ULPI_STP | ADC123_IN10
PC1 | P1.7 | 16 | PC1(5) | FT | PC1 | ETH_MDC | ADC123_IN11
PC2 | P1.10 | 17 | PC2(5) | FT | PC2 | SPI2_MISO | OTG_HS_ULPI_DIR | TH_MII_TXD2 | I2S2ext_SD | ADC123_IN12
PC3 | P1.9 | 18 | PC3(5) | FT | PC3 | SPI2_MOSI | I2S2_SD | OTG_HS_ULPI_NXT | ETH_MII_TX_CLK | ADC123_IN13
PC4 | P1.20 | 33 | PC4(5) | FT | PC4 | ETH_RMII_RX_D0 | ETH_MII_RX_D0 | ADC12_IN14
PC5 | P1.19 | 34 | PC5(5) | FT | PC5 | ETH_RMII_RX_D1 | ETH_MII_RX_D1 | ADC12_IN15
PC6 | P2.47 | 63 | PC6 | FT | PC6 | I2S2_MCK | TIM8_CH1 | SDIO_D6 | USART6_TX | DCMI_D0 | TIM3_CH1
PC7 | P2.48 | 64 | PC7 | FT | PC7 | I2S3_MCK | TIM8_CH2 | SDIO_D7 | USART6_RX | DCMI_D1 | TIM3_CH2
PC8 | P2.45 | 65 | PC8 | FT | PC8 | TIM8_CH3 | SDIO_D0 | TIM3_CH3 | USART6_CK | DCMI_D2
PC9 | P2.46 | 66 | PC9 | FT | PC9 | I2S_CKIN | MCO2 | TIM8_CH4 | SDIO_D1 | DCMI_D3 | TIM3_CH4 | I2C3_SDA
PC10 | P2.37 | 78 | PC10 | FT | PC10 | SPI3_SCK | I2S3_CK | UART4_TX | SDIO_D2 | USART3_TX | DCMI_D8
PC11 | P2.38 | 79 | PC11 | FT | PC11 | UART4_RX | SPI3_MISO | SDIO_D3 | DCMI_D4 | USART3_RX | I2S3ext_SD
PC12 | P2.35 | 80 | PC12 | FT | PC12 | UART5_TX | SDIO_CK | DCMI_D9 | SPI3_MOSI | I2S3_SD | USART3_CK
PC13 | P2.12 | 7 | PC13(3) | FT | PC13(4) | RTC_AF1
PC14 | P2.9 | 8 | PC14(3)-OSC32_IN(5) | FT | PC14(4) | OSC32_IN
PC15 | P2.10 | 9 | PC15(3)-OSC32_OUT(5) | FT | PC15(4) | OSC32_OUT
PD0 | P2.36 | 81 | PD0 | FT | PD0 | FSMC_D2 | CAN1_RX
PD1 | P2.33 | 82 | PD1 | FT | PD1 | FSMC_D3 | CAN1_TX
PD2 | P2.34 | 83 | PD2 | FT | PD2 | TIM3_ETR | UART5_RX | SDIO_CMD | DCMI_D11
PD3 | P2.31 | 84 | PD3 | FT | PD3 | FSMC_CLK | USART2_CTS
PD4 | P2.32 | 85 | PD4 | FT | PD4 | FSMC_NOE | USART2_RTS
PD5 | P2.29 | 86 | PD5 | FT | PD5 | FSMC_NWE | USART2_TX
PD6 | P2.30 | 87 | PD6 | FT | PD6 | FSMC_NWAIT | USART2_RX
PD7 | P2.27 | 88 | PD7 | FT | PD7 | USART2_CK | FSMC_NE1 | FSMC_NCE2
PD8 | P1.40 | 55 | PD8 | FT | PD8 | FSMC_D13 | USART3_TX
PD9 | P1.41 | 56 | PD9 | FT | PD9 | FSMC_D14 | USART3_RX
PD10 | P1.42 | 57 | PD10 | FT | PD10 | FSMC_D15 | USART3_CK
PD11 | P1.43 | 58 | PD11 | FT | PD11 | FSMC_A16 | USART3_CTS
PD12 | P1.44 | 59 | PD12 | FT | PD12 | FSMC_A17 | TIM4_CH1 | USART3_RTS
PD13 | P1.45 | 60 | PD13 | FT | PD13 | FSMC_A18 | TIM4_CH2
PD14 | P1.46 | 61 | PD14 | FT | PD14 | FSMC_D0 | TIM4_CH3
PD15 | P1.47 | 62 | PD15 | FT | PD15 | FSMC_D1 | TIM4_CH4
PE0 | P2.17 | 97 | PE0 | FT | PE0 | TIM4_ETR | FSMC_NBL0 | DCMI_D2
PE1 | P2.18 | 98 | PE1 | FT | PE1 | FSMC_NBL1 | DCMI_D3
PE2 | P2.15 | 1 | PE2 | FT | PE2 | TRACECLK | FSMC_A23 | ETH_MII_TXD3
PE3 | P2.16 | 2 | PE3 | FT | PE3 | TRACED0 | FSMC_A19
PE4 | P2.13 | 3 | PE4 | FT | PE4 | TRACED1 | FSMC_A20 | DCMI_D4
PE5 | P2.14 | 4 | PE5 | FT | PE5 | TRACED2 | FSMC_A21 | TIM9_CH1 | DCMI_D6
PE6 | P2.11 | 5 | PE6 | FT | PE6 | TRACED3 | FSMC_A22 | TIM9_CH2 | DCMI_D7
PE7 | P1.25 | 38 | PE7 | FT | PE7 | FSMC_D4 | TIM1_ETR
PE8 | P1.26 | 39 | PE8 | FT | PE8 | FSMC_D5 | TIM1_CH1N
PE9 | P1.27 | 40 | PE9 | FT | PE9 | FSMC_D6 | TIM1_CH1
PE10 | P1.28 | 41 | PE10 | FT | PE10 | FSMC_D7 | TIM1_CH2N
PE11 | P1.29 | 42 | PE11 | FT | PE11 | FSMC_D8 | TIM1_CH2
PE12 | P1.30 | 43 | PE12 | FT | PE12 | FSMC_D9 | TIM1_CH3N
PE13 | P1.31 | 44 | PE13 | FT | PE13 | FSMC_D10 | TIM1_CH3
PE14 | P1.32 | 45 | PE14 | FT | PE14 | FSMC_D11 | TIM1_CH4
PE15 | P1.33 | 46 | PE15 | FT | PE15 | FSMC_D12 | TIM1_BKIN
PH0 | P2.7 | 12 | PH0(5)-OSC_IN | FT | PH0 | OSC_IN
PH1 | P2.8 | 13 | PH1(5)-OSC_OUT | FT | PH1 | OSC_OUT
 |  | 99 | PDR_ON |  | PDR_ON
BOOT0 | P2.21 | 94 | BOOT0 |  | BOOT0 | VPP
NRST | P1.6 | 14 | NRST |  | NRST
 |  | 6 | VBAT |  | VBAT
 |  | 49 | VCAP_1 |  | VCAP_1
 |  | 73 | VCAP_2 |  | VCAP_2
 |  | 11 | VDD |  | VDD
 |  | 19 | VDD |  | VDD
 |  | 28 | VDD |  | VDD
 |  | 50 | VDD |  | VDD
 |  | 75 | VDD |  | VDD
 |  | 100 | VDD |  | VDD
 |  | 22 | VDDA |  | VDDA
 |  | 21 | VREF+ |  | VREF+
 |  | 10 | VSS |  | VSS
 |  | 74 | VSS |  | VSS
 |  | 27 | VSS_4 |  | VSS_4
 |  | 20 | VSSA |  | VSSA
Pin Notes:
1. Function availability depends on the chosen device.
2. The functions in bold are remapped through peripheral registers.
3. PC13, PC14, PC15 and PI8 are supplied through the power switch. Since the switch only sinks a limited amount of current (3 mA), the use of GPIOs PC13 to PC15 and PI8 in output mode is limited: the speed should not exceed 2 MHz with a maximum load of 30 pF and these I/Os must not be used as a current source (e.g. to drive an LED).
4. Main function after the first backup domain power-up. Later on, it depends on the contents of the RTC registers even after reset (because these registers are not reset by the main reset). For details on how to manage these I/Os, refer to the RTC register description sections in the STM32F46x reference manual, available from the STMicroelectronics website: www.st.com.
5. FT = 5 V tolerant except when in analog mode or oscillator mode (for PC14, PC15, PH0 and PH1).
6. If the device is delivered in an UFBGA176 and the BYPASS_REG pin is set to VDD (Regulator off/internal reset ON mode), then PA0 is used as an internal Reset (active low).
