Club-INTech/TechTheLunatic-LowLevel/hardware/INTech - Carte de Base/INTech - Carte de Base.brd

## EAGLE design hardware/INTech - Carte de Base/INTech - Carte de Base.brd (2016-08-16, last stored version)

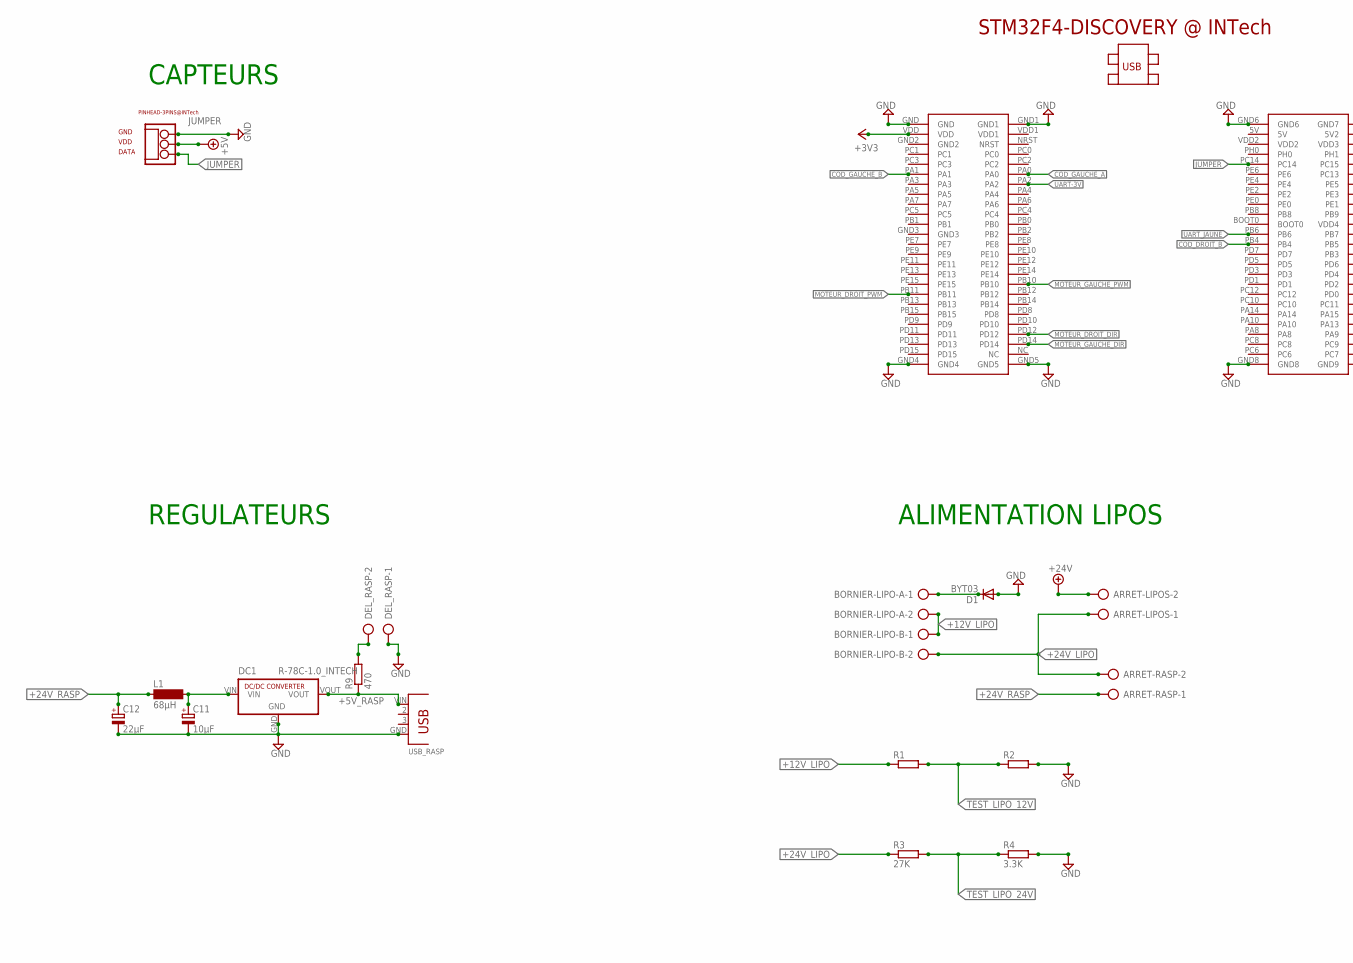
[picture p1: schematic INTech - Carte de Base.sch, part in row 1, column 1]

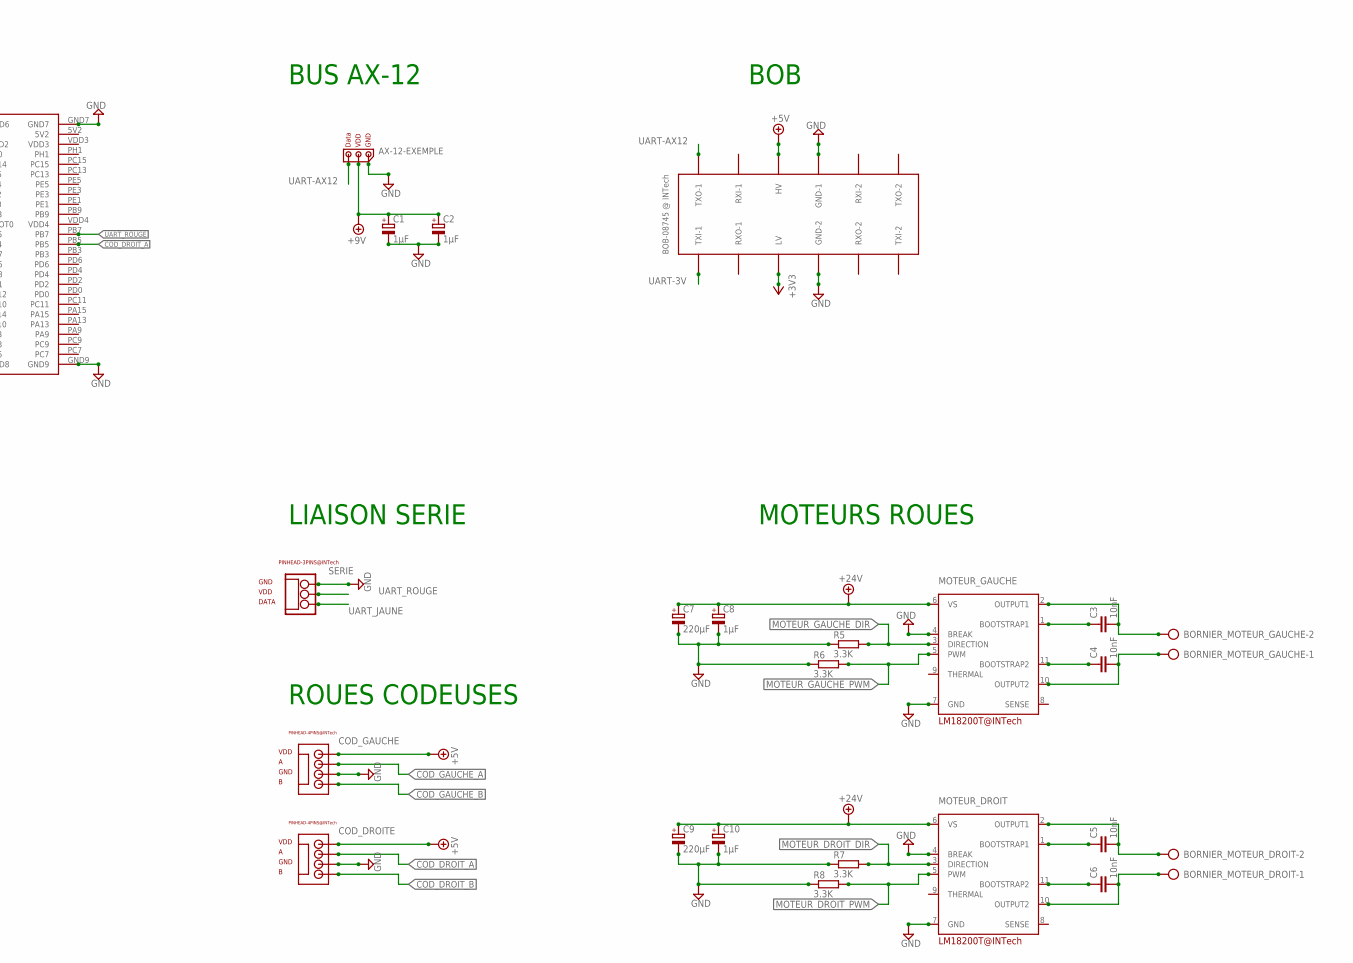
[picture p2: schematic INTech - Carte de Base.sch, part in row 1, column 2]

Parts:
ARRET-LIPOS: AK300/2
ARRET-RASP: AK300/2
AX-12-EXEMPLE: AX-12_CF_INTECH
BORNIER-LIPO-A: AK300/2
BORNIER-LIPO-B: AK300/2
BORNIER_MOTEUR_DROIT: AK300/2
BORNIER_MOTEUR_GAUCHE: AK300/2
C1, C2: 1µF; E2,5-6E
C3, C4, C5, C6: 10nF; C050-025X075
C7, C9: 220µF; E3,5-8
C8, C10: 1µF; E3,5-8
C11: 10µF; E2,5-6
C12: 22µF; E2,5-6
COD_DROITE: PINHEAD-4_CF_INTECH
COD_GAUCHE: PINHEAD-4_CF_INTECH
D1: BYT03; DO27-15
DC1: R-78C-1.0_INTECH; SIP3_INTECH
DEL_RASP: AK300/2
JUMPER: PINHEAD_CF_INTECH
L1: 68µH; SD12K100
MOTEUR_DROIT: LM18200T_CF_INTECH
MOTEUR_GAUCHE: LM18200T_CF_INTECH
R1, R2: R-EU_0207/10; 0207/10
R3: 27K; 0207/10
R4, R5, R6, R7, R8: 3.3K; 0207/10
R9: 470; 0204/7
SERIE: PINHEAD_CF_INTECH
U$1: STM32F4-DISCOVERY
U$2: BOB-08745
USB_RASP: USB_87520; USB

Connections:
+3V3: U$1.VDD, U$2.LV
+5V: COD_DROITE.VDD, COD_GAUCHE.VDD, JUMPER.VDD, U$2.HV
+5V_RASP: DC1.VOUT, R9.1, USB_RASP.VIN
+9V: AX-12-EXEMPLE.VDD, C1.+, C2.+
+12V_LIPO: BORNIER-LIPO-A.2, BORNIER-LIPO-B.1, R1.1
+24V: ARRET-LIPOS.2, C7.+, C8.+, C9.+, C10.+, MOTEUR_DROIT.6 (VS), MOTEUR_GAUCHE.6 (VS)
+24V_LIPO: ARRET-LIPOS.1, ARRET-RASP.2, BORNIER-LIPO-B.2, R3.1
+24V_RASP: ARRET-RASP.1, C12.+, L1.1
COD_DROIT_A: COD_DROITE.A, U$1.PB5
COD_DROIT_B: COD_DROITE.B, U$1.PB4
COD_GAUCHE_A: COD_GAUCHE.A, U$1.PA0
COD_GAUCHE_B: COD_GAUCHE.B, U$1.PA1
GND: AX-12-EXEMPLE.GND, C1.-, C2.-, C7.-, C8.-, C9.-, C10.-, C11.-, C12.-, COD_DROITE.GND, COD_GAUCHE.GND, D1.A, DC1.GND, DEL_RASP.1, JUMPER.GND, MOTEUR_DROIT.4 (BREAK), MOTEUR_DROIT.7 (GND), MOTEUR_GAUCHE.4 (BREAK), MOTEUR_GAUCHE.7 (GND), R2.2, R4.2, R5.1, R6.1, R7.1, R8.1, SERIE.GND, U$1.GND, U$1.GND1, U$1.GND4, U$1.GND5, U$1.GND6, U$1.GND7, U$1.GND8, U$1.GND9, U$2.GND-1, U$2.GND-2, USB_RASP.GND
JUMPER: JUMPER.DATA, U$1.PC14
MOTEUR_DROIT_DIR: MOTEUR_DROIT.3 (DIRECTION), R7.2, U$1.PD12
MOTEUR_DROIT_PWM: MOTEUR_DROIT.5 (PWM), R8.2, U$1.PB11
MOTEUR_GAUCHE_DIR: MOTEUR_GAUCHE.3 (DIRECTION), R5.2, U$1.PD14
MOTEUR_GAUCHE_PWM: MOTEUR_GAUCHE.5 (PWM), R6.2, U$1.PB10
unnamed: BORNIER-LIPO-A.1, D1.C
unnamed: C4.1, MOTEUR_GAUCHE.11 (BOOTSTRAP2)
unnamed: C3.1, MOTEUR_GAUCHE.1 (BOOTSTRAP1)
unnamed: C5.1, MOTEUR_DROIT.1 (BOOTSTRAP1)
unnamed: C6.1, MOTEUR_DROIT.11 (BOOTSTRAP2)
unnamed: C11.+, DC1.VIN, L1.2
unnamed: DEL_RASP.2, R9.2
unnamed: BORNIER_MOTEUR_GAUCHE.2, C3.2, MOTEUR_GAUCHE.2 (OUTPUT1)
unnamed: BORNIER_MOTEUR_GAUCHE.1, C4.2, MOTEUR_GAUCHE.10 (OUTPUT2)
unnamed: BORNIER_MOTEUR_DROIT.2, C5.2, MOTEUR_DROIT.2 (OUTPUT1)
unnamed: BORNIER_MOTEUR_DROIT.1, C6.2, MOTEUR_DROIT.10 (OUTPUT2)
TEST_LIPO_12V: R1.2, R2.1
TEST_LIPO_24V: R3.2, R4.1
UART-3V: U$1.PA2, U$2.TXI-1
UART-AX12: AX-12-EXEMPLE.DATA, U$2.TXO-1
UART_JAUNE: SERIE.DATA, U$1.PB6
UART_ROUGE: SERIE.VDD, U$1.PB7

Notes on the sheet:
BUS AX-12
BOB
ALIMENTATION LIPOS
LIAISON SERIE
MOTEURS ROUES
ROUES CODEUSES
CAPTEURS
REGULATEURS

Board: 2 copper layers, 41 parts (0 on the bottom side), 35 nets, no tracks yet.
