Club-INTech/TechTheLunatic-LowLevel/hardware/Robot principal/robot.brd

## EAGLE design hardware/Robot principal/robot.brd (2016-07-14, last stored version)

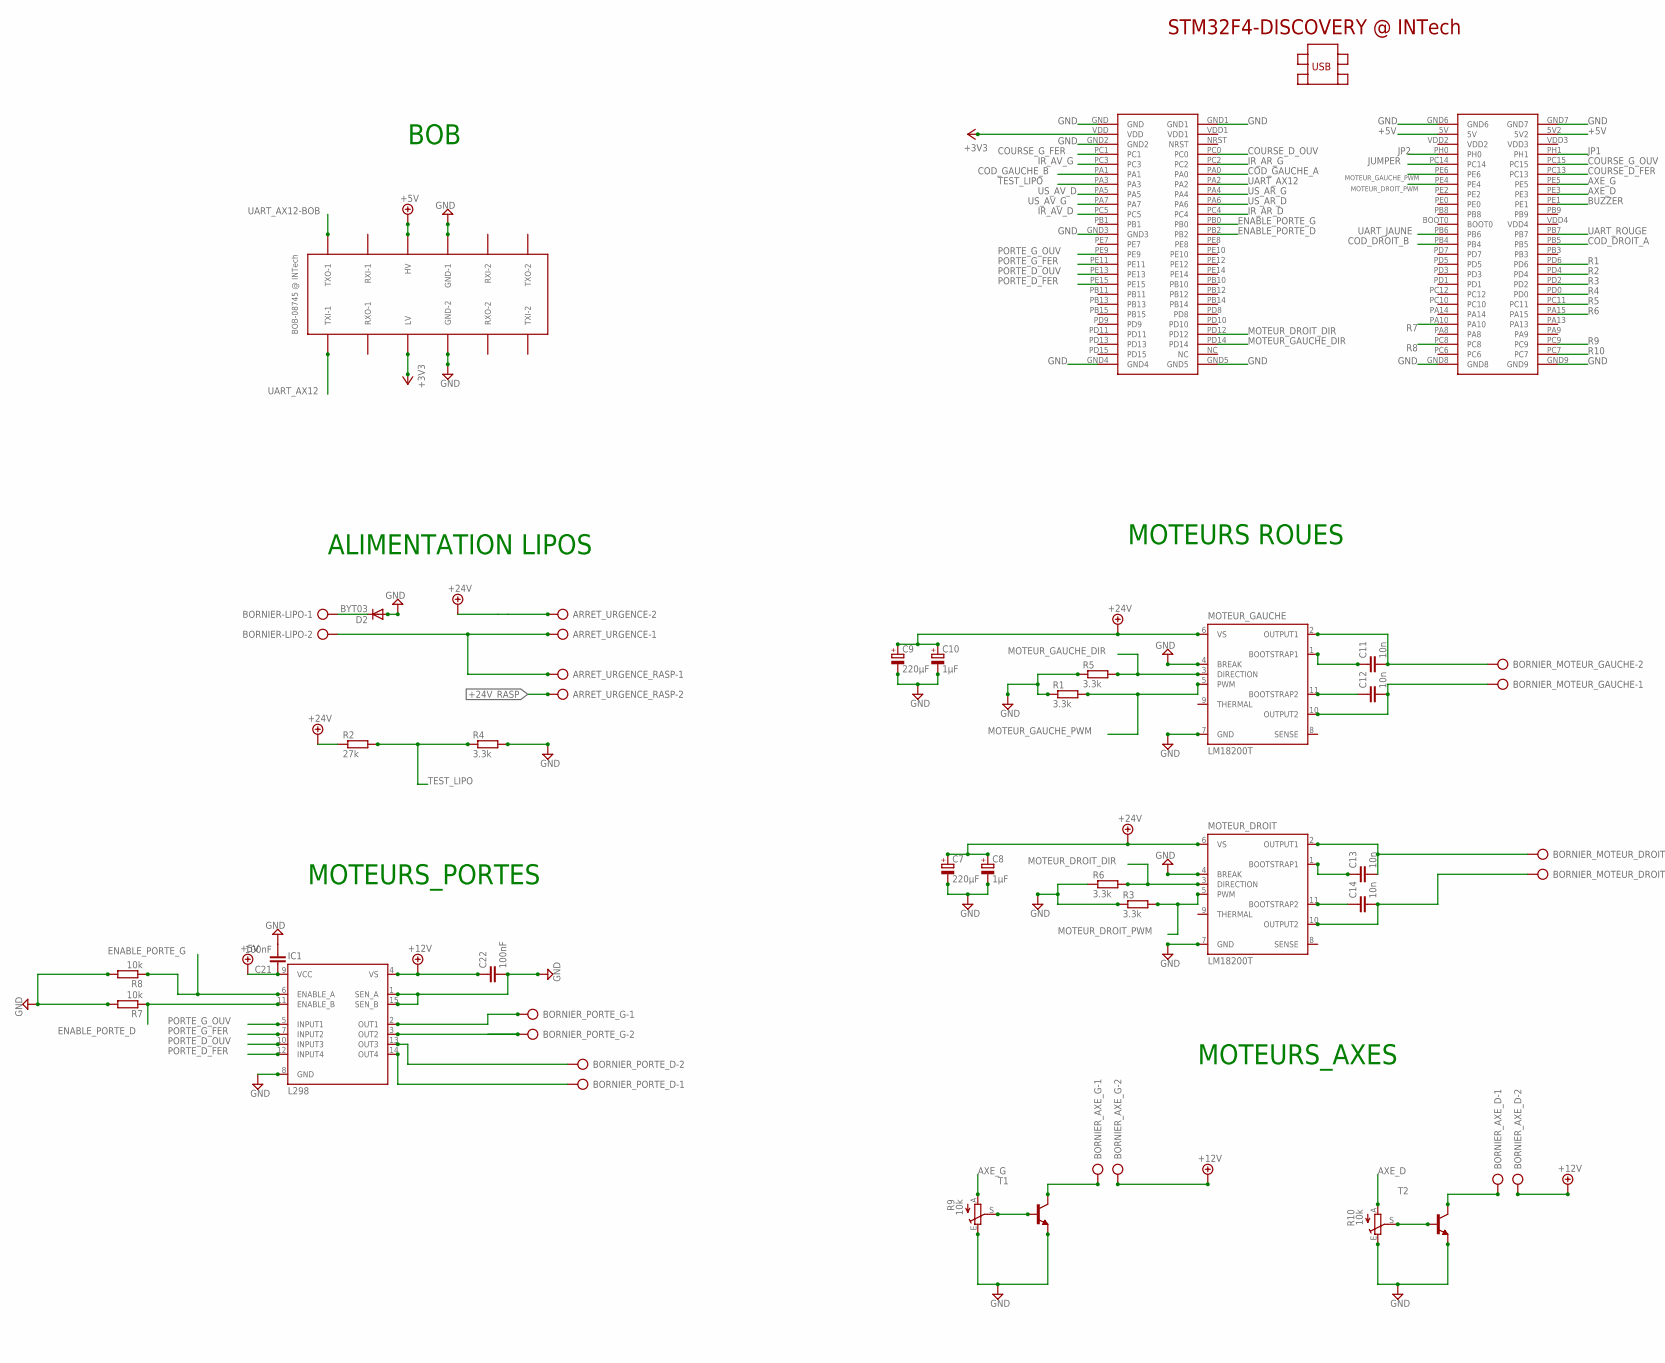
[picture p3: schematic robot.sch, part in row 1, column 1]

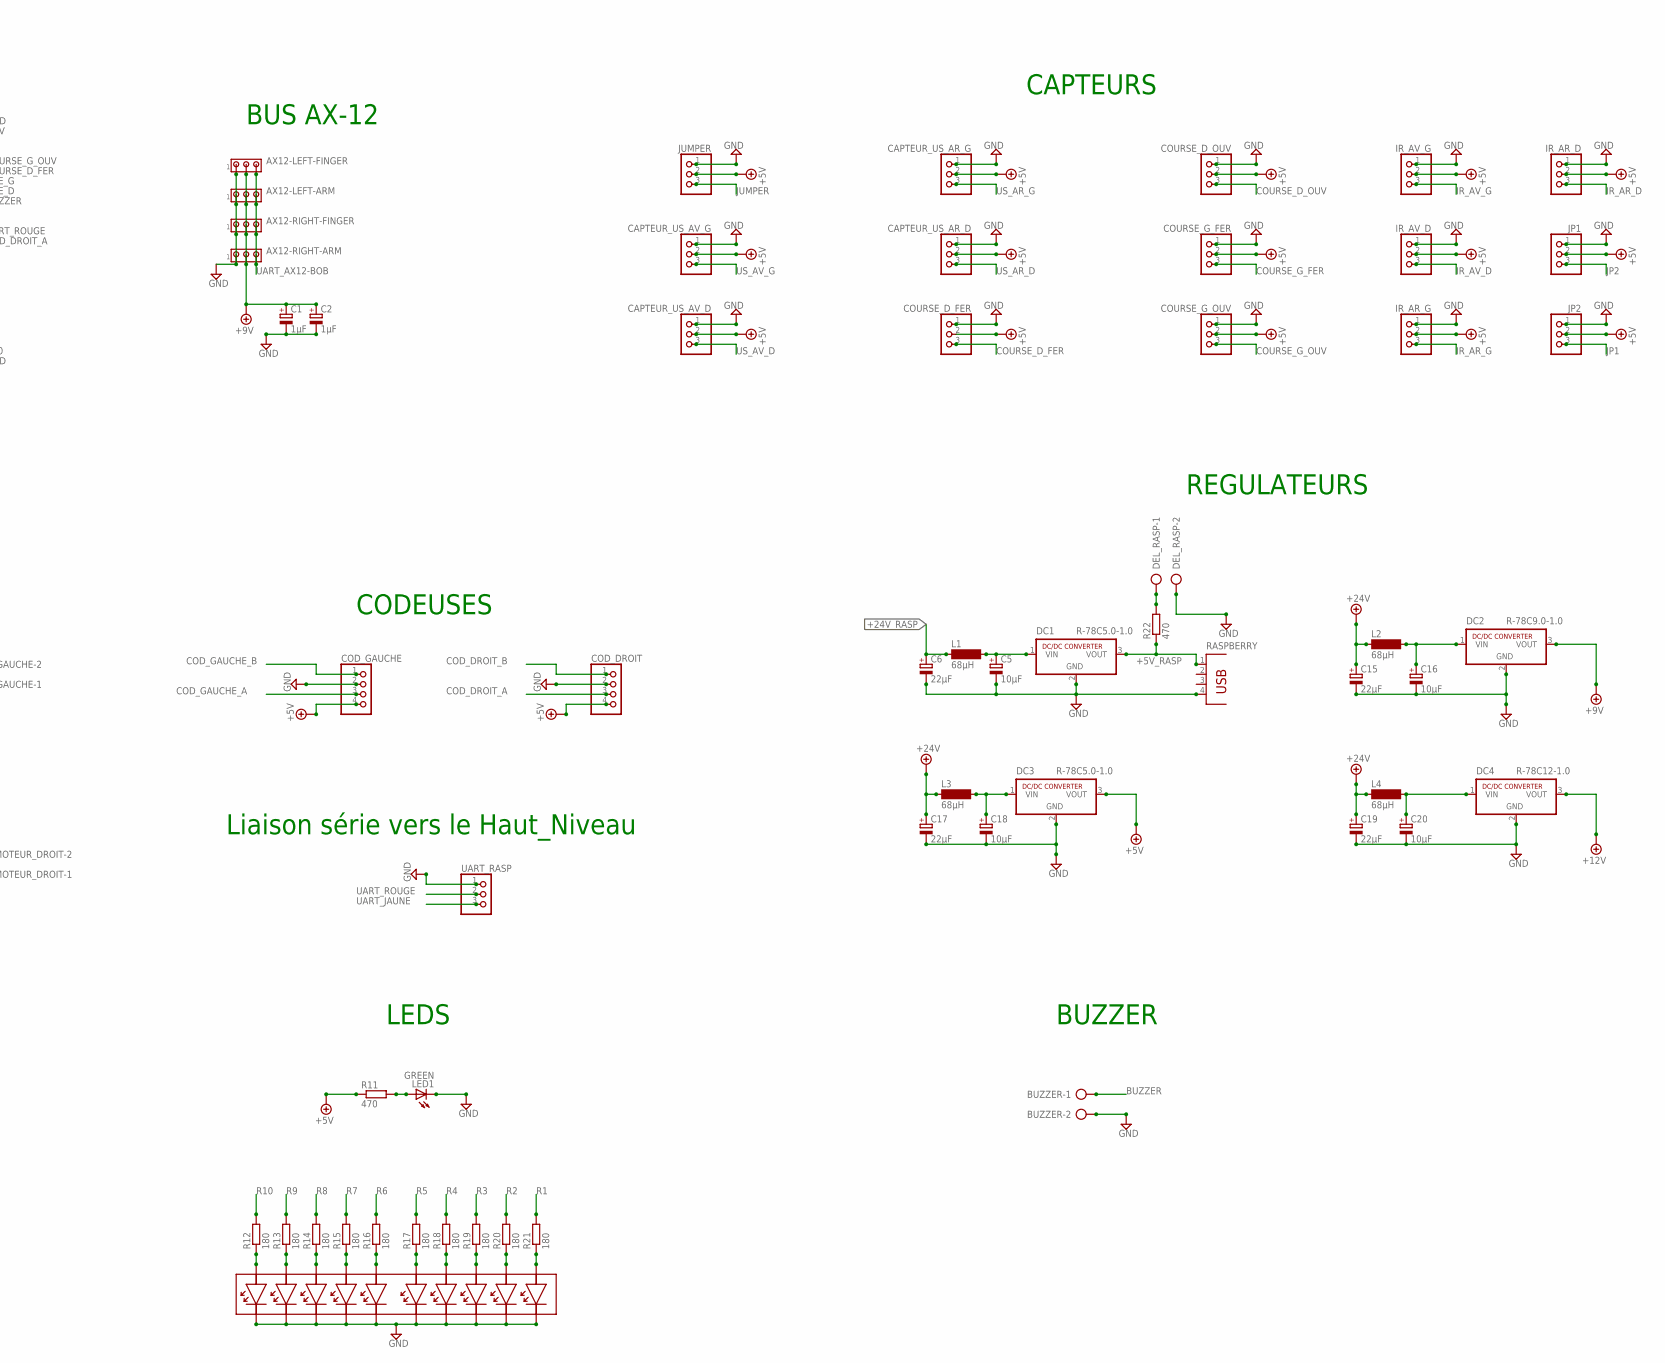
[picture p4: schematic robot.sch, part in row 1, column 2]

Parts:
ARRET_URGENCE: AK300/2
ARRET_URGENCE_RASP: AK300/2
AX12-LEFT-ARM, AX12-LEFT-FINGER, AX12-RIGHT-ARM, AX12-RIGHT-FINGER: MTA03-100; 10X03MTA
BOB-08745: BOB-08745
BORNIER-LIPO: AK300/2
BORNIER_AXE_D: AK300/2
BORNIER_AXE_G: AK300/2
BORNIER_MOTEUR_DROIT: AK300/2
BORNIER_MOTEUR_GAUCHE: AK300/2
BORNIER_PORTE_D: AK300/2
BORNIER_PORTE_G: AK300/2
BUZZER: AK300/2
C1, C2: 1µF; E2,5-6E
C5, C16, C18, C20: 10µF; E2,5-6E
C6, C15, C17, C19: 22µF; E2,5-6E
C7, C9: 220µF; E3,5-8
C8, C10: 1µF; E3,5-8
C11, C12, C13, C14: 10n; C050-025X075
C21, C22: 100nF; C050-024X044
CAPTEUR_US_AR_D: PINHD-1X3; 1X03
CAPTEUR_US_AR_G: PINHD-1X3; 1X03
CAPTEUR_US_AV_D: PINHD-1X3; 1X03
CAPTEUR_US_AV_G: PINHD-1X3; 1X03
COD_DROIT: PINHD-1X4; 1X04
COD_GAUCHE: PINHD-1X4; 1X04
COURSE_D_FER: PINHD-1X3; 1X03
COURSE_D_OUV: PINHD-1X3; 1X03
COURSE_G_FER: PINHD-1X3; 1X03
COURSE_G_OUV: PINHD-1X3; 1X03
D2: BYT03; DO27-15
DC1, DC3: R-78C5.0-1.0; SIP3
DC2: R-78C9.0-1.0; SIP3
DC4: R-78C12-1.0; SIP3
DEL_RASP: AK300/2
IC1: L298; MULTIWATT-15
IR_AR_D: PINHD-1X3; 1X03
IR_AR_G: PINHD-1X3; 1X03
IR_AV_D: PINHD-1X3; 1X03
IR_AV_G: PINHD-1X3; 1X03
JP1, JP2: PINHD-1X3; 1X03
JUMPER: PINHD-1X3; 1X03
L1, L2, L3, L4: 68µH; SD12K100
LED1: GREEN; LED5MM
MOTEUR_DROIT: LM18200T; TO-220-11
MOTEUR_GAUCHE: LM18200T; TO-220-11
R1, R3: 3.3k; 0207/7
R2: 27k; 0207/10
R4, R5, R6: 3.3k; 0207/10
R7, R8: 10k; 0207/10
R9, R10: 10k; CA9H
R11: 470; 0207/2V
R12, R13, R14, R15, R16, R17, R18, R19, R20, R21: 180; 0207/2V
R22: 470; 0204/7
RASPBERRY: PN87520
T1, T2: 2N5400-NPN-TO92-CBE; TO92-CBE
U$1: STM32F4-DISCOVERY
U$2: DELS10RACK
UART_RASP: PINHD-1X3; 1X03

Connections:
+3V3: BOB-08745.LV, U$1.VDD
+5V: BOB-08745.HV, C21.1, CAPTEUR_US_AR_D.2, CAPTEUR_US_AR_G.2, CAPTEUR_US_AV_D.2, CAPTEUR_US_AV_G.2, COD_DROIT.4, COD_GAUCHE.4, COURSE_D_FER.2, COURSE_D_OUV.2, COURSE_G_FER.2, COURSE_G_OUV.2, DC3.3 (VOUT), IC1.9 (VCC), IR_AR_D.2, IR_AR_G.2, IR_AV_D.2, IR_AV_G.2, JP1.2, JP2.2, JUMPER.2, R11.1, U$1.5V, U$1.5V2
+5V_RASP: DC1.3 (VOUT), R22.1, RASPBERRY.1
+9V: AX12-LEFT-ARM.2, AX12-LEFT-FINGER.2, AX12-RIGHT-ARM.2, AX12-RIGHT-FINGER.2, C1.+, C2.+, DC2.3 (VOUT)
+12V: BORNIER_AXE_D.2, BORNIER_AXE_G.2, C22.1, DC4.3 (VOUT), IC1.4 (VS)
+24V: ARRET_URGENCE.2, C7.+, C8.+, C9.+, C10.+, C15.+, C17.+, C19.+, L2.1, L3.1, L4.1, MOTEUR_DROIT.6 (VS), MOTEUR_GAUCHE.6 (VS), R2.1
+24V_LIPO: ARRET_URGENCE.1, ARRET_URGENCE_RASP.1, BORNIER-LIPO.2
+24V_RASP: ARRET_URGENCE_RASP.2, C6.+, L1.1
AXE_D: R10.A, U$1.PE3
AXE_G: R9.A, U$1.PE5
BUZZER: BUZZER.1, U$1.PE1
COD_DROIT_A: COD_DROIT.3, U$1.PB5
COD_DROIT_B: COD_DROIT.1, U$1.PB4
COD_GAUCHE_A: COD_GAUCHE.3, U$1.PA0
COD_GAUCHE_B: COD_GAUCHE.1, U$1.PA1
COURSE_D_FER: COURSE_D_FER.3, U$1.PC13
COURSE_D_OUV: COURSE_D_OUV.3, U$1.PC0
COURSE_G_FER: COURSE_G_FER.3, U$1.PC1
COURSE_G_OUV: COURSE_G_OUV.3, U$1.PC15
ENABLE_PORTE_D: IC1.11 (ENABLE_B), R7.1, U$1.PB2
ENABLE_PORTE_G: IC1.6 (ENABLE_A), R8.1, U$1.PB0
GND: AX12-LEFT-ARM.1, AX12-LEFT-FINGER.1, AX12-RIGHT-ARM.1, AX12-RIGHT-FINGER.1, BOB-08745.GND-1, BOB-08745.GND-2, BUZZER.2, C1.-, C2.-, C5.-, C6.-, C7.-, C8.-, C9.-, C10.-, C15.-, C16.-, C17.-, C18.-, C19.-, C20.-, C21.2, C22.2, CAPTEUR_US_AR_D.1, CAPTEUR_US_AR_G.1, CAPTEUR_US_AV_D.1, CAPTEUR_US_AV_G.1, COD_DROIT.2, COD_GAUCHE.2, COURSE_D_FER.1, COURSE_D_OUV.1, COURSE_G_FER.1, COURSE_G_OUV.1, D2.A, DC1.2 (GND), DC2.2 (GND), DC3.2 (GND), DC4.2 (GND), DEL_RASP.2, IC1.1 (SEN_A), IC1.8 (GND), IC1.15 (SEN_B), IR_AR_D.1, IR_AR_G.1, IR_AV_D.1, IR_AV_G.1, JP1.1, JP2.1, JUMPER.1, LED1.K (C), MOTEUR_DROIT.4 (BREAK), MOTEUR_DROIT.7 (GND), MOTEUR_GAUCHE.4 (BREAK), MOTEUR_GAUCHE.7 (GND), R1.1, R3.1, R4.2, R5.1, R6.1, R7.2, R8.2, R9.E, R10.E, RASPBERRY.4, T1.E, T2.E, U$1.GND, U$1.GND1, U$1.GND2, U$1.GND3, U$1.GND4, U$1.GND5, U$1.GND6, U$1.GND7, U$1.GND8, U$1.GND9, U$2.11, U$2.12, U$2.13, U$2.14, U$2.15, U$2.16, U$2.17, U$2.18, U$2.19, U$2.20, UART_RASP.1
IR_AR_D: IR_AR_D.3, U$1.PC4
IR_AR_G: IR_AR_G.3, U$1.PC2
IR_AV_D: IR_AV_D.3, U$1.PC5
IR_AV_G: IR_AV_G.3, U$1.PC3
JP1: JP2.3, U$1.PH1
JP2: JP1.3, U$1.PH0
JUMPER: JUMPER.3, U$1.PC14
MOTEUR_DROIT_DIR: MOTEUR_DROIT.3 (DIRECTION), R6.2, U$1.PD12
MOTEUR_DROIT_PWM: MOTEUR_DROIT.5 (PWM), R3.2, U$1.PE4
MOTEUR_GAUCHE_DIR: MOTEUR_GAUCHE.3 (DIRECTION), R5.2, U$1.PD14
MOTEUR_GAUCHE_PWM: MOTEUR_GAUCHE.5 (PWM), R1.2, U$1.PE6
unnamed: R10.S, T2.B
unnamed: R9.S, T1.B
unnamed: DEL_RASP.1, R22.2
unnamed: BORNIER-LIPO.1, D2.C
unnamed: BORNIER_AXE_G.1, T1.C
unnamed: LED1.A, R11.2
unnamed: BORNIER_PORTE_D.1, IC1.14 (OUT4)
unnamed: C14.1, MOTEUR_DROIT.11 (BOOTSTRAP2)
unnamed: BORNIER_MOTEUR_GAUCHE.1, C12.2, MOTEUR_GAUCHE.10 (OUTPUT2)
unnamed: C11.1, MOTEUR_GAUCHE.1 (BOOTSTRAP1)
unnamed: BORNIER_MOTEUR_DROIT.2, C13.2, MOTEUR_DROIT.2 (OUTPUT1)
unnamed: BORNIER_MOTEUR_DROIT.1, C14.2, MOTEUR_DROIT.10 (OUTPUT2)
unnamed: C20.+, DC4.1 (VIN), L4.2
unnamed: C13.1, MOTEUR_DROIT.1 (BOOTSTRAP1)
unnamed: C5.+, DC1.1 (VIN), L1.2
unnamed: BORNIER_MOTEUR_GAUCHE.2, C11.2, MOTEUR_GAUCHE.2 (OUTPUT1)
unnamed: C18.+, DC3.1 (VIN), L3.2
unnamed: C12.1, MOTEUR_GAUCHE.11 (BOOTSTRAP2)
unnamed: C16.+, DC2.1 (VIN), L2.2
unnamed: R12.1, U$2.10
unnamed: R13.1, U$2.9
unnamed: BORNIER_AXE_D.1, T2.C
unnamed: R14.1, U$2.8
unnamed: BORNIER_PORTE_G.1, IC1.2 (OUT1)
unnamed: R15.1, U$2.7
unnamed: BORNIER_PORTE_G.2, IC1.3 (OUT2)
unnamed: BORNIER_PORTE_D.2, IC1.13 (OUT3)
unnamed: R16.1, U$2.6
unnamed: R17.1, U$2.5
unnamed: R18.1, U$2.4
unnamed: R19.1, U$2.3
unnamed: R20.1, U$2.2
unnamed: R21.1, U$2.1
PORTE_D_FER: IC1.12 (INPUT4), U$1.PE15
PORTE_D_OUV: IC1.10 (INPUT3), U$1.PE13
PORTE_G_FER: IC1.7 (INPUT2), U$1.PE11
PORTE_G_OUV: IC1.5 (INPUT1), U$1.PE9
R1: R21.2, U$1.PD6
R2: R20.2, U$1.PD4
R3: R19.2, U$1.PD2
R4: R18.2, U$1.PD0
R5: R17.2, U$1.PC11
R6: R16.2, U$1.PA15
R7: R15.2, U$1.PA10
R8: R14.2, U$1.PC8
R9: R13.2, U$1.PC9
R10: R12.2, U$1.PC7
TEST_LIPO: R2.2, R4.1, U$1.PA3
UART_AX12: BOB-08745.TXI-1, U$1.PA2
UART_AX12-BOB: AX12-LEFT-ARM.3, AX12-LEFT-FINGER.3, AX12-RIGHT-ARM.3, AX12-RIGHT-FINGER.3, BOB-08745.TXO-1
UART_JAUNE: U$1.PB6, UART_RASP.3
UART_ROUGE: U$1.PB7, UART_RASP.2
US_AR_D: CAPTEUR_US_AR_D.3, U$1.PA6
US_AR_G: CAPTEUR_US_AR_G.3, U$1.PA4
US_AV_D: CAPTEUR_US_AV_D.3, U$1.PA5
US_AV_G: CAPTEUR_US_AV_G.3, U$1.PA7

Notes on the sheet:
BUS AX-12
CAPTEURS
CODEUSES
Liaison série vers le Haut_Niveau
MOTEURS ROUES
REGULATEURS
BOB
ALIMENTATION LIPOS
MOTEURS_PORTES
MOTEURS_AXES
LEDS
BUZZER

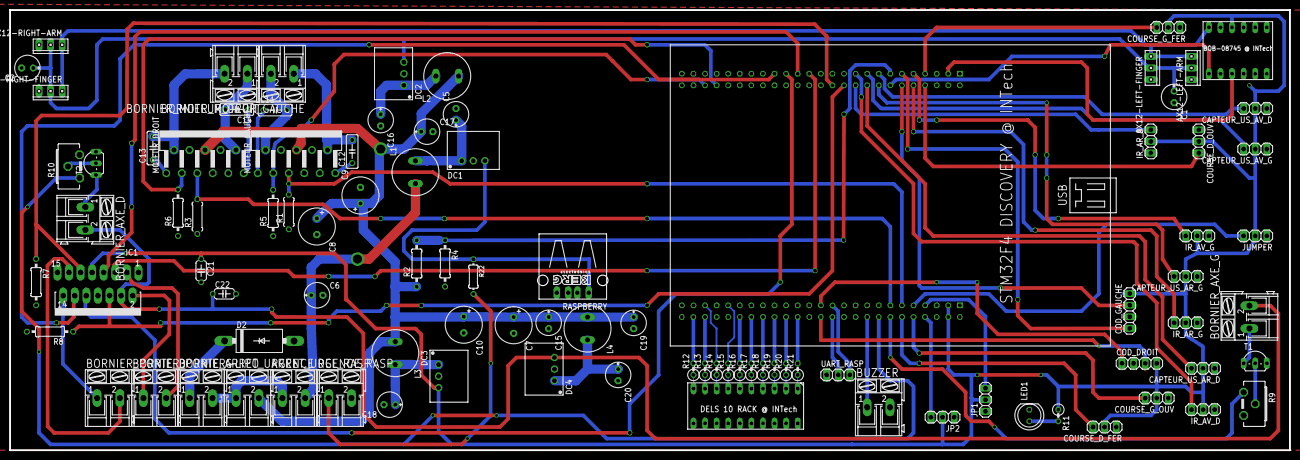
[picture p5: board robot.brd from above]

Board: 2 copper layers, 280.7 x 96.5 mm, 94 parts (0 on the bottom side), 89 nets.
