Club-INTech/TechTheLunatic-LowLevel/hardware/les yeux/oeuil.brd

## EAGLE design hardware/les yeux/oeuil.brd (2016-07-14, last stored version)

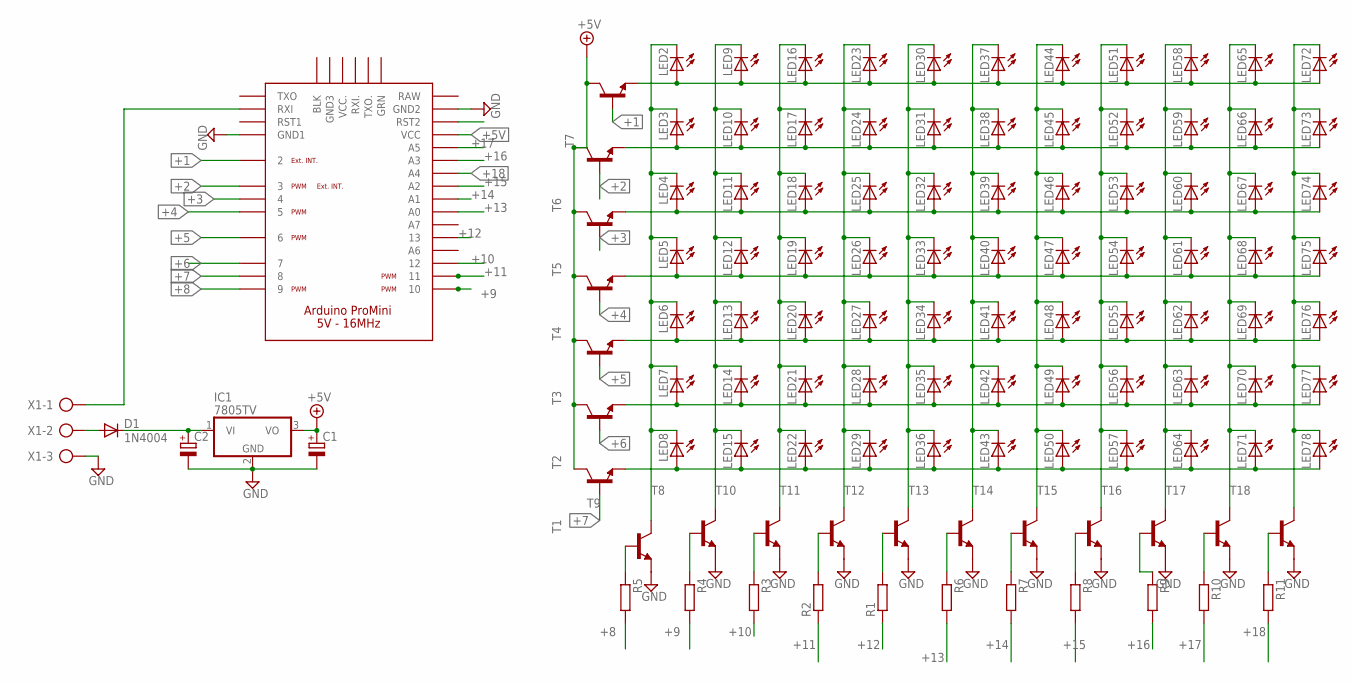
[picture p6: schematic oeuil.sch]

Parts:
C1, C2: CPOL-EUE2,5-6E; E2,5-6E
D1: 1N4004; DO41-10
IC1: 7805TV; TO220V
LED2, LED3, LED4, LED5, LED6, LED7, LED8, LED9, LED10, LED11, LED12, LED13, LED14, LED15, LED16, LED17, LED18, LED19, LED20, LED21, LED22, LED23, LED24, LED25, LED26, LED27, LED28, LED29, LED30, LED31, LED32, LED33, LED34, LED35, LED36, LED37, LED38, LED39, LED40, LED41, LED42, LED43, LED44, LED45, LED46, LED47, LED48, LED49, LED50, LED51, LED52, LED53, LED54, LED55, LED56, LED57, LED58, LED59, LED60, LED61, LED62, LED63, LED64, LED65, LED66, LED67, LED68, LED69, LED70, LED71, LED72, LED73, LED74, LED75, LED76, LED77, LED78: LED3MM
R1, R2, R3, R4, R5, R6, R7, R8, R9, R10, R11: R-EU_0207/2V; 0207/2V
T1, T2, T3, T4, T5, T6, T7, T8, T9, T10, T11, T12, T13, T14, T15, T16, T17, T18: 2N4124-NPN-TO92-CBE; TO92-CBE
U$1: ARDUINO_PRO_MINI
X1: AK300/3

Connections:
+1: T7.B, U$1.2
+2: T6.B, U$1.3
+3: T5.B, U$1.4
+4: T4.B, U$1.5
+5: T3.B, U$1.6
+5V: C1.+, IC1.3 (VO), T1.C, T2.C, T3.C, T4.C, T5.C, T6.C, T7.C, U$1.VCC1 (VCC)
+6: T2.B, U$1.7
+7: T1.B, U$1.8
+8: R5.2, U$1.9
+9: R4.2, U$1.10
+10: R3.2, U$1.12
+11: R2.1, U$1.11
+12: R1.1, U$1.13
+13: R6.2, U$1.A0
+14: R7.2, U$1.A1
+15: R8.2, U$1.A2
+16: R9.2, U$1.A3
+17: R10.2, U$1.A5
+18: R11.2, U$1.A4
GND: C1.-, C2.-, IC1.2 (GND), T8.E, T9.E, T10.E, T11.E, T12.E, T13.E, T14.E, T15.E, T16.E, T17.E, T18.E, U$1.GND1, U$1.GND2, X1.3
unnamed: C2.+, D1.C, IC1.1 (VI)
unnamed: LED9.K (C), LED10.K (C), LED11.K (C), LED12.K (C), LED13.K (C), LED14.K (C), LED15.K (C), T8.C
unnamed: LED16.K (C), LED17.K (C), LED18.K (C), LED19.K (C), LED20.K (C), LED21.K (C), LED22.K (C), T10.C
unnamed: LED51.K (C), LED52.K (C), LED53.K (C), LED54.K (C), LED55.K (C), LED56.K (C), LED57.K (C), T15.C
unnamed: LED23.K (C), LED24.K (C), LED25.K (C), LED26.K (C), LED27.K (C), LED28.K (C), LED29.K (C), T11.C
unnamed: LED30.K (C), LED31.K (C), LED32.K (C), LED33.K (C), LED34.K (C), LED35.K (C), LED36.K (C), T12.C
unnamed: LED37.K (C), LED38.K (C), LED39.K (C), LED40.K (C), LED41.K (C), LED42.K (C), LED43.K (C), T13.C
unnamed: LED44.K (C), LED45.K (C), LED46.K (C), LED47.K (C), LED48.K (C), LED49.K (C), LED50.K (C), T14.C
unnamed: LED58.K (C), LED59.K (C), LED60.K (C), LED61.K (C), LED62.K (C), LED63.K (C), LED64.K (C), T16.C
unnamed: LED65.K (C), LED66.K (C), LED67.K (C), LED68.K (C), LED69.K (C), LED70.K (C), LED71.K (C), T17.C
unnamed: LED72.K (C), LED73.K (C), LED74.K (C), LED75.K (C), LED76.K (C), LED77.K (C), LED78.K (C), T18.C
unnamed: LED8.A, LED15.A, LED22.A, LED29.A, LED36.A, LED43.A, LED50.A, LED57.A, LED64.A, LED71.A, LED78.A, T1.E
unnamed: R5.1, T9.B
unnamed: R4.1, T8.B
unnamed: R3.1, T10.B
unnamed: R2.2, T11.B
unnamed: R1.2, T12.B
unnamed: R6.1, T13.B
unnamed: R7.1, T14.B
unnamed: R8.1, T15.B
unnamed: R9.1, T16.B
unnamed: R10.1, T17.B
unnamed: R11.1, T18.B
unnamed: LED2.A, LED9.A, LED16.A, LED23.A, LED30.A, LED37.A, LED44.A, LED51.A, LED58.A, LED65.A, LED72.A, T7.E
unnamed: D1.A, X1.2
unnamed: U$1.RXI1 (RXI), X1.1
unnamed: LED6.A, LED13.A, LED20.A, LED27.A, LED34.A, LED41.A, LED48.A, LED55.A, LED62.A, LED69.A, LED76.A, T3.E
unnamed: LED7.A, LED14.A, LED21.A, LED28.A, LED35.A, LED42.A, LED49.A, LED56.A, LED63.A, LED70.A, LED77.A, T2.E
unnamed: LED5.A, LED12.A, LED19.A, LED26.A, LED33.A, LED40.A, LED47.A, LED54.A, LED61.A, LED68.A, LED75.A, T4.E
unnamed: LED4.A, LED11.A, LED18.A, LED25.A, LED32.A, LED39.A, LED46.A, LED53.A, LED60.A, LED67.A, LED74.A, T5.E
unnamed: LED3.A, LED10.A, LED17.A, LED24.A, LED31.A, LED38.A, LED45.A, LED52.A, LED59.A, LED66.A, LED73.A, T6.E
unnamed: LED2.K (C), LED3.K (C), LED4.K (C), LED5.K (C), LED6.K (C), LED7.K (C), LED8.K (C), T9.C

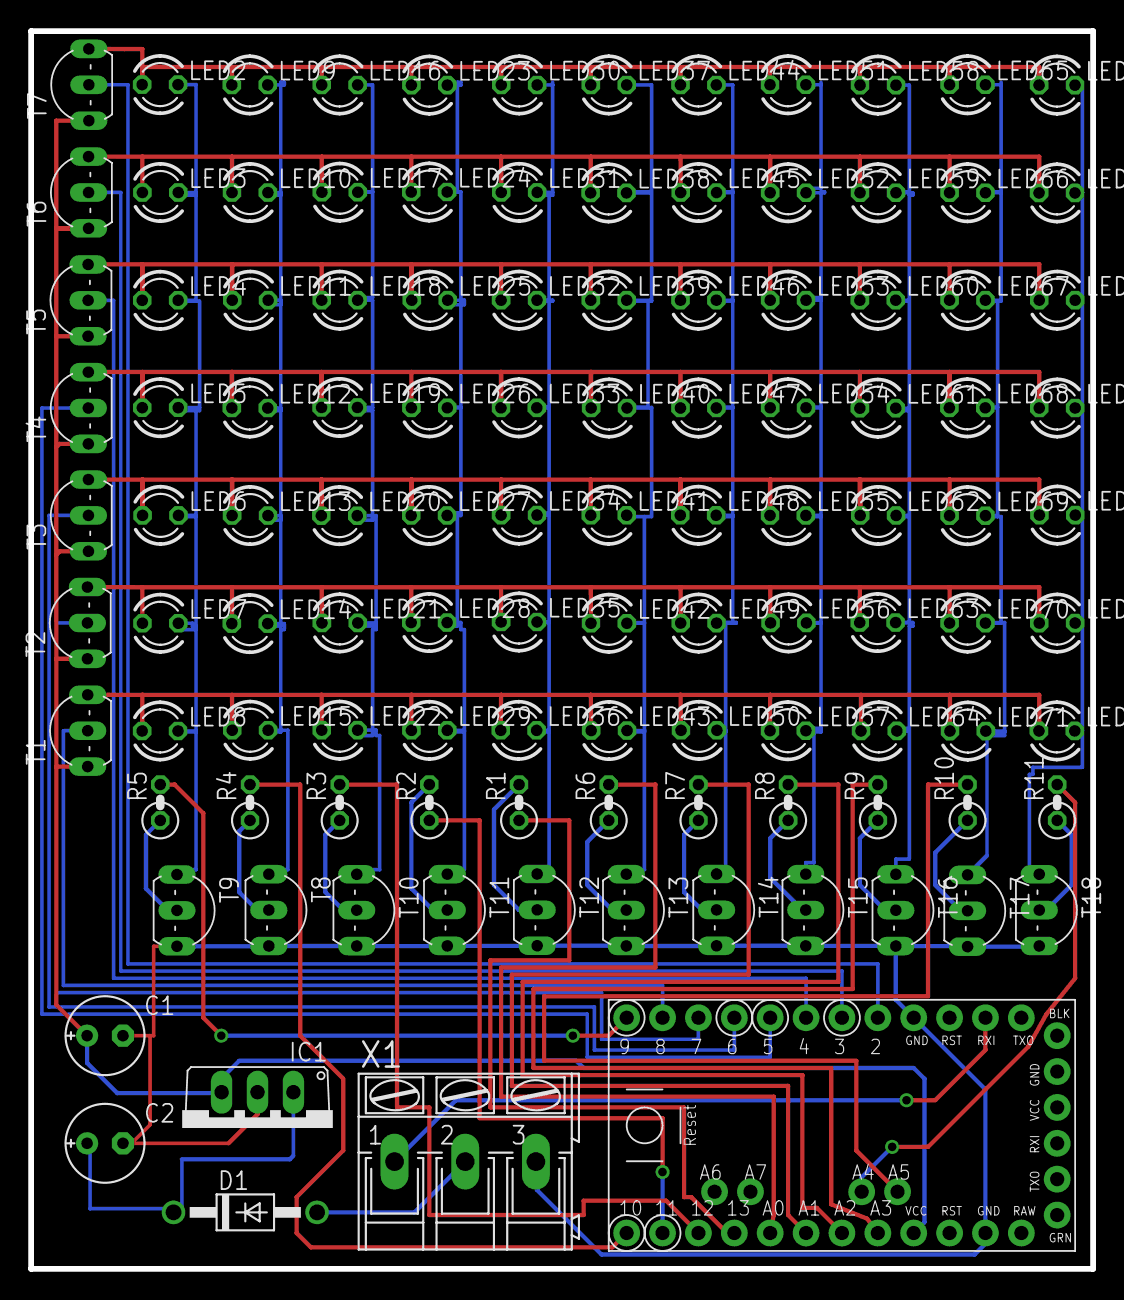
[picture p7: board oeuil.brd from above]

Board: 2 copper layers, 75.2 x 87.6 mm, 112 parts (0 on the bottom side), 52 nets.
