Club-INTech/TechTheLunatic-LowLevel/projects/complete_low_level/include/SensorMgr.h

#ifndef SENSOR_MGR_H
#define SENSOR_MGR_H

#include "stm32f4xx.h"
#include "stm32f4xx_tim.h"
#include "stm32f4xx_gpio.h"
#include "stm32f4xx_rcc.h"
//#include "stm32f4xx_spi.h"
#include "stm32f4xx_exti.h"
#include "stm32f4xx_syscfg.h"
#include "misc.h"
#include "capteur_srf05.hpp"
#include "Singleton.hpp"
#include "MotionControlSystem.h"
#include <Uart.hpp>

extern Uart<1> serial;

class SensorMgr : public Singleton<SensorMgr>
{
public:
	SensorMgr();


	int getSensorDistanceARD();
    int getSensorDistanceARG();
    int getSensorDistanceAVD();
    int getSensorDistanceAVG();

	bool isJumperOut() const;
	bool isContactor1engaged() const;
	bool isContactor2engaged() const;
	bool isContactor3engaged() const;

	void refresh(MOVING_DIRECTION);

	void sensorInterrupt(int);
private:
    CapteurSRF ultrasonAVD;
    CapteurSRF ultrasonAVG;
	CapteurSRF ultrasonARD;
    CapteurSRF ultrasonARG;


	unsigned int refreshDelay;
	unsigned int currentTime;
	unsigned int lastRefreshTime;
};


#endif
