Club-INTech/TechTheLunatic-LowLevel/projects/complete_low_level/src/Counter.cpp

/**
 * Counter.cpp
 *
 * Classe de d�codage des codeurs
 *
 */

#include "Counter.h"

Counter::Counter() {

	/**
	 * Configuration encodeur DROIT sur TIMER 5 (32 bits)
	 * Pins A0 (jaune) et A1 (vert)
	 */

	RCC_AHB1PeriphClockCmd(RCC_AHB1Periph_GPIOA, ENABLE);
	RCC_APB1PeriphClockCmd(RCC_APB1Periph_TIM5, ENABLE);

	GPIO_InitTypeDef GPIO_InitStruct;
	GPIO_StructInit(&GPIO_InitStruct);
	GPIO_InitStruct.GPIO_Pin = GPIO_Pin_0 | GPIO_Pin_1;
	GPIO_InitStruct.GPIO_Speed = GPIO_Speed_100MHz;
	GPIO_InitStruct.GPIO_Mode = GPIO_Mode_AF;
	GPIO_InitStruct.GPIO_OType = GPIO_OType_PP;
	GPIO_InitStruct.GPIO_PuPd = GPIO_PuPd_UP;
	GPIO_Init(GPIOA, &GPIO_InitStruct);

	GPIO_PinAFConfig(GPIOA, GPIO_PinSource0, GPIO_AF_TIM5);
	GPIO_PinAFConfig(GPIOA, GPIO_PinSource1, GPIO_AF_TIM5);

	//Mode encoder du timer 5
	TIM_EncoderInterfaceConfig(TIM5, TIM_EncoderMode_TI12,
			TIM_ICPolarity_Rising, TIM_ICPolarity_Rising);

	TIM_TimeBaseInitTypeDef TIM_TimeBaseStructure;
	TIM_TimeBaseStructInit(&TIM_TimeBaseStructure);
	TIM_TimeBaseStructure.TIM_Prescaler = 0;
	TIM_TimeBaseStructure.TIM_CounterMode = TIM_CounterMode_Up;
	TIM_TimeBaseStructure.TIM_Period = -1;
	TIM_TimeBaseStructure.TIM_ClockDivision = TIM_CKD_DIV1;
	TIM_TimeBaseInit(TIM5, &TIM_TimeBaseStructure);

	TIM_Cmd(TIM5, ENABLE);

	TIM_SetCounter(TIM5, 2147483647);

	/**
	 * Configuration encodeur GAUCHE sur TIMER 3 (16 bits) A GARDER
	 * Pins B4 et B5
	 */

	RCC_AHB1PeriphClockCmd(RCC_AHB1Periph_GPIOB, ENABLE);
	RCC_APB1PeriphClockCmd(RCC_APB1Periph_TIM3, ENABLE);

	GPIO_StructInit(&GPIO_InitStruct);
	GPIO_InitStruct.GPIO_Pin = GPIO_Pin_4 | GPIO_Pin_5 ;
	GPIO_InitStruct.GPIO_Speed = GPIO_Speed_100MHz;
	GPIO_InitStruct.GPIO_Mode = GPIO_Mode_AF;
	GPIO_InitStruct.GPIO_OType = GPIO_OType_PP;
	GPIO_InitStruct.GPIO_PuPd = GPIO_PuPd_UP;
	GPIO_Init(GPIOB, &GPIO_InitStruct);

	GPIO_PinAFConfig(GPIOB, GPIO_PinSource4, GPIO_AF_TIM3);
	GPIO_PinAFConfig(GPIOB, GPIO_PinSource5, GPIO_AF_TIM3);

	//Mode encoder du timer 3
	TIM_EncoderInterfaceConfig(TIM3, TIM_EncoderMode_TI12,
			TIM_ICPolarity_Rising, TIM_ICPolarity_Rising);

	TIM_TimeBaseStructInit(&TIM_TimeBaseStructure);
	TIM_TimeBaseStructure.TIM_Prescaler = 0;
	TIM_TimeBaseStructure.TIM_CounterMode = TIM_CounterMode_Up;
	TIM_TimeBaseStructure.TIM_Period = -1;
	TIM_TimeBaseStructure.TIM_ClockDivision = TIM_CKD_DIV1;
	TIM_TimeBaseInit(TIM3, &TIM_TimeBaseStructure);

	TIM_Cmd(TIM3, ENABLE);

	TIM_SetCounter(TIM3, 32767);
}

int32_t Counter::getLeftValue() {
	//Translate to int32_t
	return ((TIM_GetCounter(TIM5)-2147483647));
}

int32_t Counter::getRightValue() {
	//Translate to int16_t
	return ((TIM_GetCounter(TIM3)-32767));
}
