Club-INTech/TechTheLunatic-LowLevel/(commit log)

2016-07-14 Petit commit de rien du tout
    [INTech - Carte de Base.brd, INTech - Carte de Base.sch, Pinout_STM32_F4DISCOVERY.xls, oeuil.brd, oeuil.sch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]
2016-07-14 Suppression de fichiers inutiles
2016-07-14 Je vire les eeprom.c et .h non utilisés
2016-07-14 j'enlève encore des trucs inutiles
2016-07-15 j'ai bougé le dossier library avant de CTRL+A DELETE le main.c
2016-07-16 clean de sensorManager
2016-07-17 Suite du nettoyage + suppression des fichiers binaryMotorManager
2016-07-18 Enlevage de bazar
    [oeuil.brd, oeuil.sch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]
2016-07-30 ajout de la librairie eagle de la STM32F407VGT6
2016-07-30 clean du dépot de lunatic
    [robot.brd, robot.sch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]
2016-08-05 maj de certaines librairies
    [INTech - Carte de Base.brd, INTech - Carte de Base.sch]
2016-08-06 Ajout de texte pour les régulateurs de tension
    [INTech - Carte de Base.brd, INTech - Carte de Base.sch]
2016-08-06 C'est mieux avec les modifs de libs
2016-08-16 Légères modif et ajout de 2 librairies
    [INTech - Carte de Base.brd, INTech - Carte de Base.sch]
2016-08-18 ajout du fichier indispensable pour compiler (stm32_flash.ld)
2016-08-19 changement de la frequence du quartz, qui etait fausse !
2016-08-21 nettoyage interface + ajout des 2 autres canaux
2016-08-21 debut de l'interface graphique de test LL
2016-08-28 Compilation des librairies classiques en 1 seule
2016-09-11 oublié de add...
2016-10-11 ajout du printflnPosition, et POSITION_HEADER
2016-10-11 dernieres modifs de l'interface : ajout canal position
2016-10-12 ça marche pas ouf mais c'est un début de lecture de position
2016-10-12 ajout de l'ordre auto, pour activer l'envoi auto de la position
2016-10-17 Meilleure lisibilité sur le board des librairies INTech
2016-11-14 AX12 low speed corrected
    [ActuatorsMgr.hpp]
2016-11-24 modification du main et actuator manager pour tester les ax12
2016-11-25 ax12 de la pelleteuse
2016-11-27 Ajout du code arduino pour le robot_secondaire
2016-11-27 Ajout de la librairie AX12 pour arduino
2016-11-28 + cnst de reload timer après jumper
2016-11-30 ajout d'ordres dans la liste de la docu' bas niveau
2016-11-30 correction de bourde (toujours sur la docu)
2016-12-01 fonction suppléméntaire pour la pelle
2016-12-01 ajout des commandes dans la doc ll
2016-12-03 Changements de nom et ajout d'un ordre dans la doc
2016-12-09 ajout des executables st-link qui marchent + documentation pour les installer
2016-12-12 recommentationnage des lignes dans sendPacket
2017-01-11 début de gestion de l'ascenseur
2017-01-12 moteur sans pwm
2017-01-13 ajout de pwm sur l'ascenseur, valeurs à paramétrer
2017-01-13 Ajout fcn de recuperation de l'etat des contacteurs
2017-01-13 correction de fichiers
2017-01-13 ça remarche, moteur sans pwm
2017-01-14 code ctrl batteries Lipo
2017-01-19 retour des leds de batterie+ascenseur plus précis
2017-01-19 ascenseur rescussité (sans pwm) en attendant une nouvelle stm
2017-01-19 woohoo, pwm
2017-01-21 méthode dégueulasse pour l'ascenseur, TODO: la rendre moins dégueulasse
2017-01-21 fonctions pour slopes et punches, à tester sur un ax12 avec un poids dessus pour voir les effets, et à terme peut être oser espérer avoir des accélérations moins violentes
2017-01-23 changement de pin pwm, en fait le commi précédent était une idée à la con, vafalloir faire de la soudure sur le shield
2017-01-24 script screen pratique de sa maman master
2017-01-24 tentative de correction ax master
    [ActuatorsMgr.hpp, Elevator.cpp, main.cpp]
2017-01-26 Modifs : main(ordres largue-modules), ActuatorMgr(limites) et ax12(changement vitesse).
2017-01-27 angles ax, reasserv plus ax(sinon les vitesses/mouvements sont modifiés de façon incontrolable)
2017-02-07 Le commit de la maniaque!
2017-02-13 changement vecteurs d'interruption pour les capteurs
2017-02-14 Dernières modifs pour les capteurs
2017-02-14 pas besoin de regarder ce commit^^
2017-02-19 angles ax changés car mauvais ax sur la meca !
2017-02-24 sens robot corrigé degueulassement, ax angles optimisés un peu
    [ActuatorsMgr.hpp, Counter.cpp, Motor.cpp, main.cpp]
2017-02-25 Correction bis, pb de git ubuntu corrigé
    [Counter.cpp, Motor.cpp, main.cpp]
2017-02-25 remise au bon endroit de stm32_flash.ld
2017-03-01 Angles ax corrigés, modifs interface serie
    [ActuatorsMgr.hpp, MotionControlSystem.cpp, MotionControlSystem.h]
2017-03-03 docu + délais de stop
2017-03-07 master marche à peu près sur l'ancienne carte, TODO refaire le new-card à partir de master
2017-03-07 angles ax corrigés ancienne carte
    [ActuatorsMgr.hpp]
2017-03-07 pines usées de new-card
    [PinesUsees.ods]
2017-03-08 codeuses, commandes de test
2017-03-10 Ascenseur à peu près asservi (reste à gérer les constantes)
2017-03-11 TODO: beaucoup de ticks de la codeuse sont ratées, probablement des roues aussi(moins sensibles) + c'est un problème de software(marche bien sur la teensy de sylvain)
2017-03-11 correction du compteur d'overflows de la codeuse gauche
    [MotionControlSystem.cpp]
2017-03-11 Le robot roule bien Medium fonctionne en marche arrière(probablement plus, faudra modifier les valeurs du haut niveau pour les vitesses)
2017-03-13 Toujours un problème de pwm droit qui part en cacahuète
2017-03-15 3 capteurs (arrière droite gauche + avant gauche) fonctionnent relativement bien (entre 20 cm et 1m), mais l'un des capteurs (avant droit, sur EXTI0 et pas EXTI15-10 comme les autres, bloque la série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
2017-03-16 Première tentative capteurs, failed
    [main.cpp]
2017-03-17 code pour que le dernier capteur puisse fonctionner
2017-03-18 motor+capteurs envoyés en interruption par le canal US
2017-03-21 Capteurs bien pinés sur les pines qu'il faut :)
2017-03-21 motionCtrl probleme de copier coller corrigé
    [MotionControlSystem.cpp]
2017-03-22 essai de réglage asserv -- attention codeuse droite qui saute bcp de ticks
2017-04-17 voltage controller ok
2017-04-17 décommentationnage de certaines fonctions(pfdebug)
2017-04-18 modifs ActuatorMgr
2017-04-18 asserv ascenseur(on évide de dire au moteur de bouger sans arrêt)
2017-04-19 "si t'es en train de bouger, bouge !", la logique et moi ça fait 2(correction elevatorMgr))
    [Elevator.cpp, Elevator.h, ElevatorMgr.cpp, SensorMgr.cpp]
2017-04-19 l'elec c'est pour les pds, + modifs elevatormgr
    [INTech - Carte de Base.brd, INTech - Carte de Base.sch]
2017-04-20 pelleteuse a l'air de bien marcher
2017-04-20 ajout de commentaires
2017-04-20 mini-modif, les capteurs fonctionnent tous SUUS
2017-04-21 Ajout d'un délais d'envoi des données capteur
2017-04-25 ajout ordre dans le ramassage des balles
2017-04-25 affichage des ticks en prenant en compte l'overflow
2017-05-04 tentative correction probleme de série perdue
    [ElevatorMgr.cpp, ElevatorMgr.h]
2017-05-08 mise à jour de capteurs pas assez vite
2017-05-09 debug actuatororder
2017-05-09 Retour à la branche master
2017-05-15 refresh hors envoi de données
2017-05-15 Plus long timeout, logs de debug, retour à la position initiale si blocage
2017-05-17 retrait de certains printflnDebug, switchscreen
2017-05-17 ordre bpdm pour livrer les boules à la fin
2017-05-18 On envoie pas des doubles dans un pourcentf de printf MONGOLO
2017-05-18 séparation en fonctions différentes des ordres par côtés, par soucis de clarité
2017-05-18 ajouts ordres p1 et p2 pour éviter le blocage des boules dans la pelle
2017-05-18 petit clean + ascenseur refonctionnel + timeout+compteur de timeout pour l'ascenseur(retente l'action précédente 2 fois avant d'arrêter jusqu'à ce que le HL redemande une action)
2017-05-19 timeout un peu plus court, changements de sens inutiles retirés... J'vois toujours pas pourquoi le timeout n'est pas atteint dans de rares occasions
2017-05-19 ajustements, ascenseur va plus vite(pour etre sur que le module soit bien en haut), accelerations asserv plus lents
2017-05-19 pourquoi on check deux fois si on a dépassé ou non le delay de refresh des capteurs? xD
2017-05-20 L'asserv c'était mieux avant !(le changement de patins après la dernière asserv' a tout fait capoter)
2017-05-21 ascenseur plus lent en descente(tappe moins fort le contacteur, dans le doute, et osef de celui en haut il est bien fat)
2017-05-23 voltage controler avec min voltage, mais pas réussi à mettre echelon correct, et certaines pins ont pas l'air ouf, à corriger
    [main.cpp]
2017-05-23 ordre des pins corrigé
2017-05-26 asserv un peu mieux à la coupe, position pelle plus basse en haut et plus haute en bas(désasservis moins), hack capteurs
